NguyenHien-8/Nabertherm/README.md

# Nabertherm
- Developer: Trần Nguyên Hiền
- Instructor: Trần Hữu Danh
- Major: Electronics and Communication Engineering
- School: CAN THO UNIVERSITY
- Email: trannguyenhien29085@gmail.com
-----------------------------------------------------
<div style="display: flex; justify-content: center; gap: 10px; margin-bottom: 15px;">
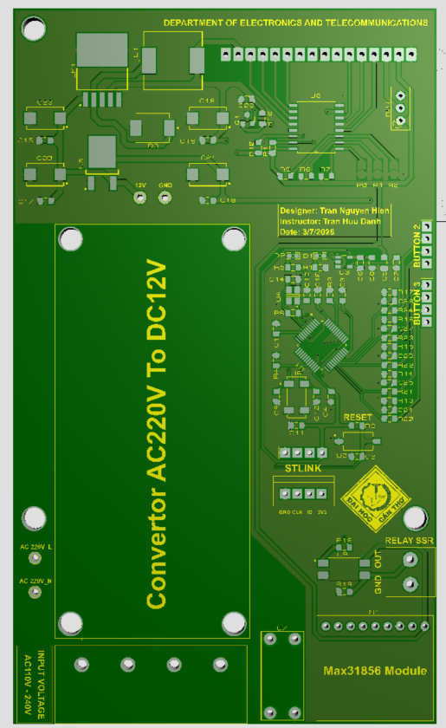
[picture p1: Document/Image/Top_3D.png]
  
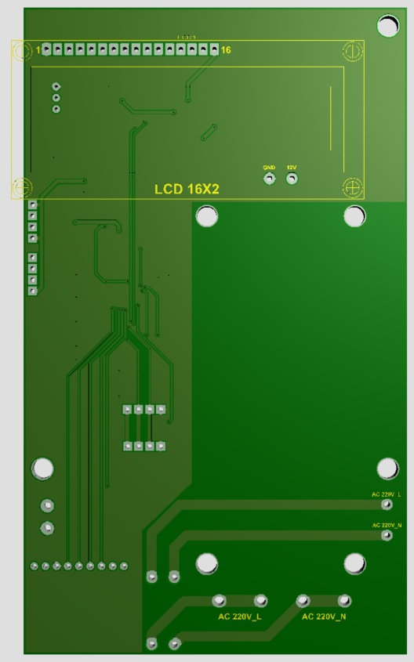
[picture p2: Document/Image/Bottom_3D.png]
  
</div>
