NguyenHien-8/Nabertherm/Document/Image/Dashboard/1786791415155_257126981631082276_1126023047263535637_b54764be3a68f17b69153251596af111.jpg

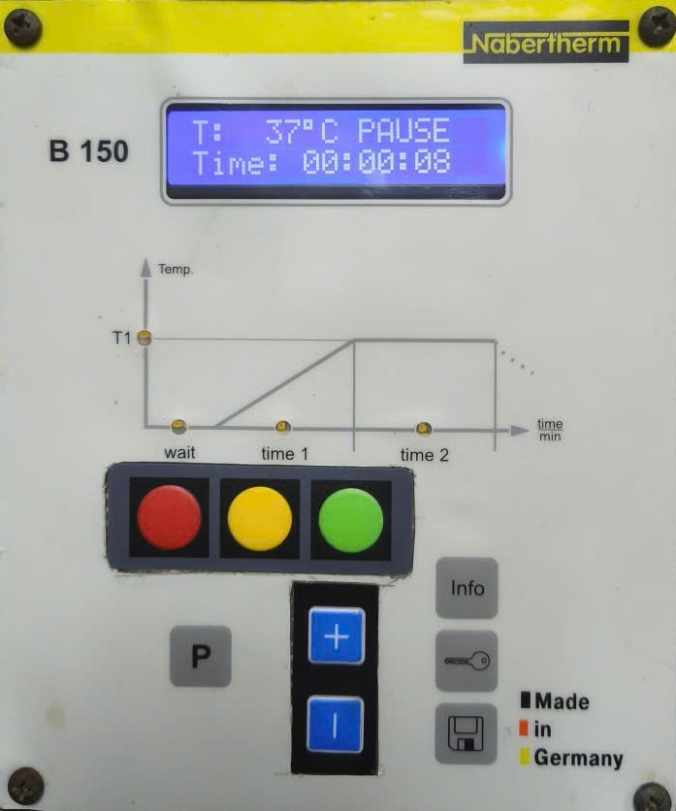
Document/Image/Dashboard/1786791415155_257126981631082276_1126023047263535637_b54764be3a68f17b69153251596af111.jpg
