NguyenHien-8/Nabertherm/Document/Image/Dashboard/1786791415245_257126981631082276_1126023047263535637_783d4723ad5a51a8d0b6619117eda769.jpg

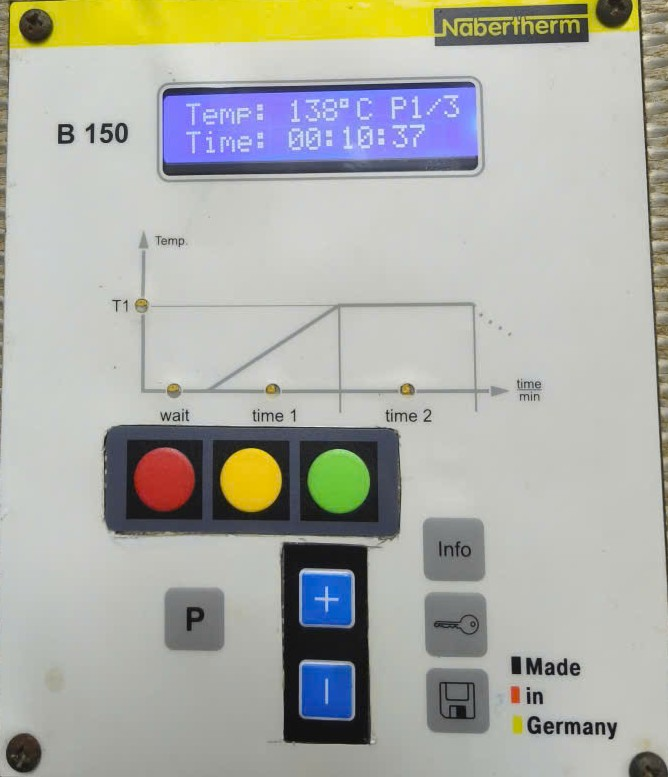
Document/Image/Dashboard/1786791415245_257126981631082276_1126023047263535637_783d4723ad5a51a8d0b6619117eda769.jpg
