NguyenHien-8/Nabertherm/Document/Image/Dashboard/1786791415838_257126981631082276_1126023047263535637_0a16da0144fe33b08d0fe1ec7425ece5.jpg

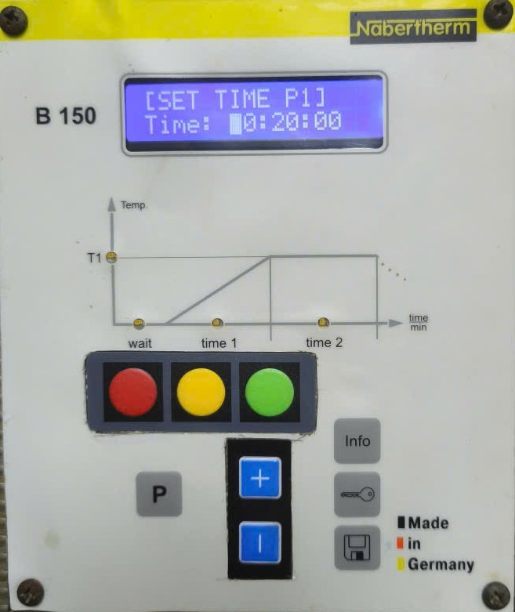
Document/Image/Dashboard/1786791415838_257126981631082276_1126023047263535637_0a16da0144fe33b08d0fe1ec7425ece5.jpg
