NguyenHien-8/Nabertherm/Document/Image/Flowchart/01_main_flow.png

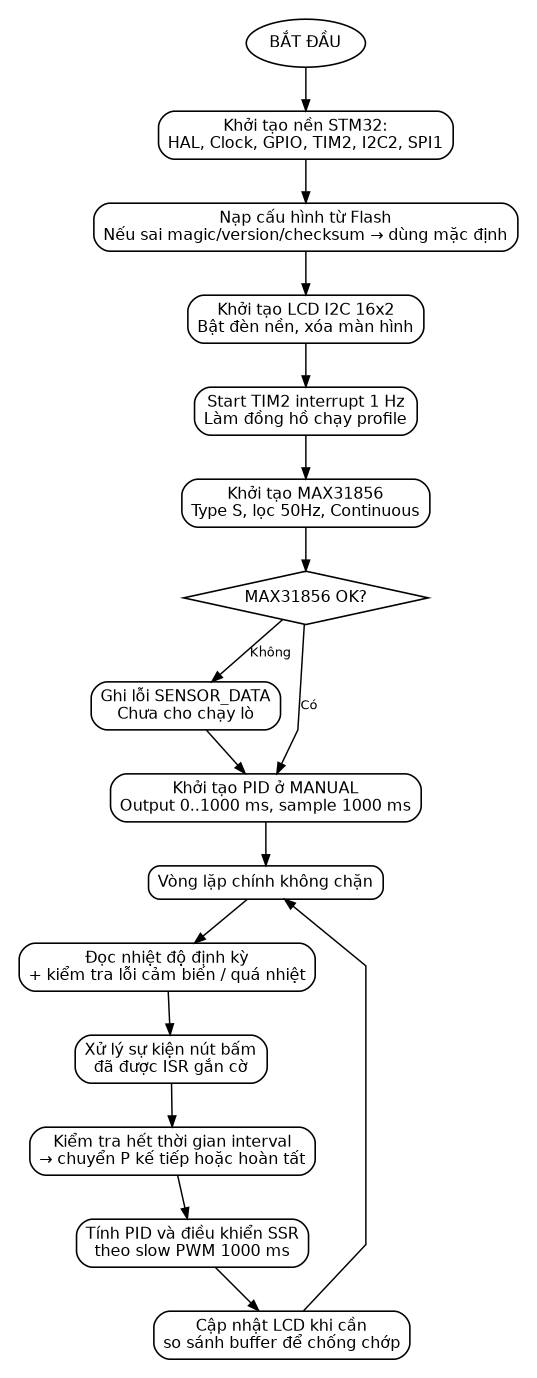
Document/Image/Flowchart/01_main_flow.png
