NguyenHien-8/Nabertherm/Document/Image/Flowchart/02_interrupt_flow.png

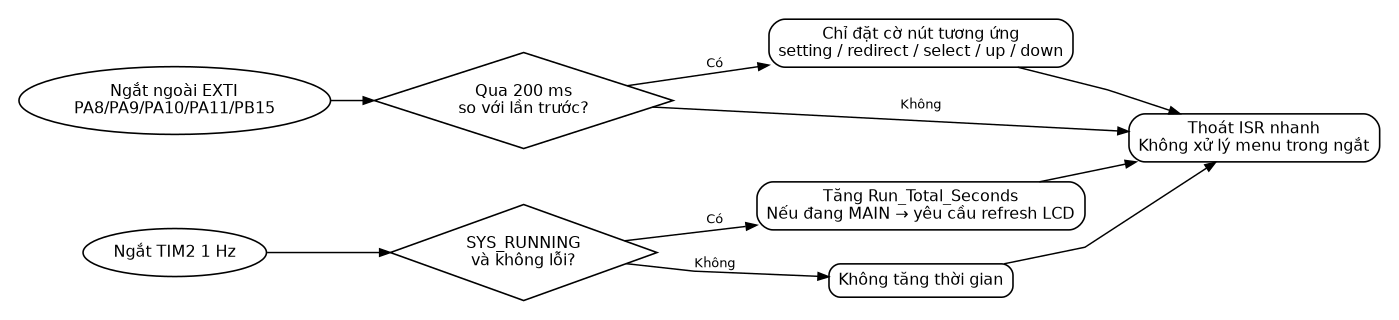
Document/Image/Flowchart/02_interrupt_flow.png
