NguyenHien-8/Nabertherm/Document/Image/Flowchart/03_read_temperature.png

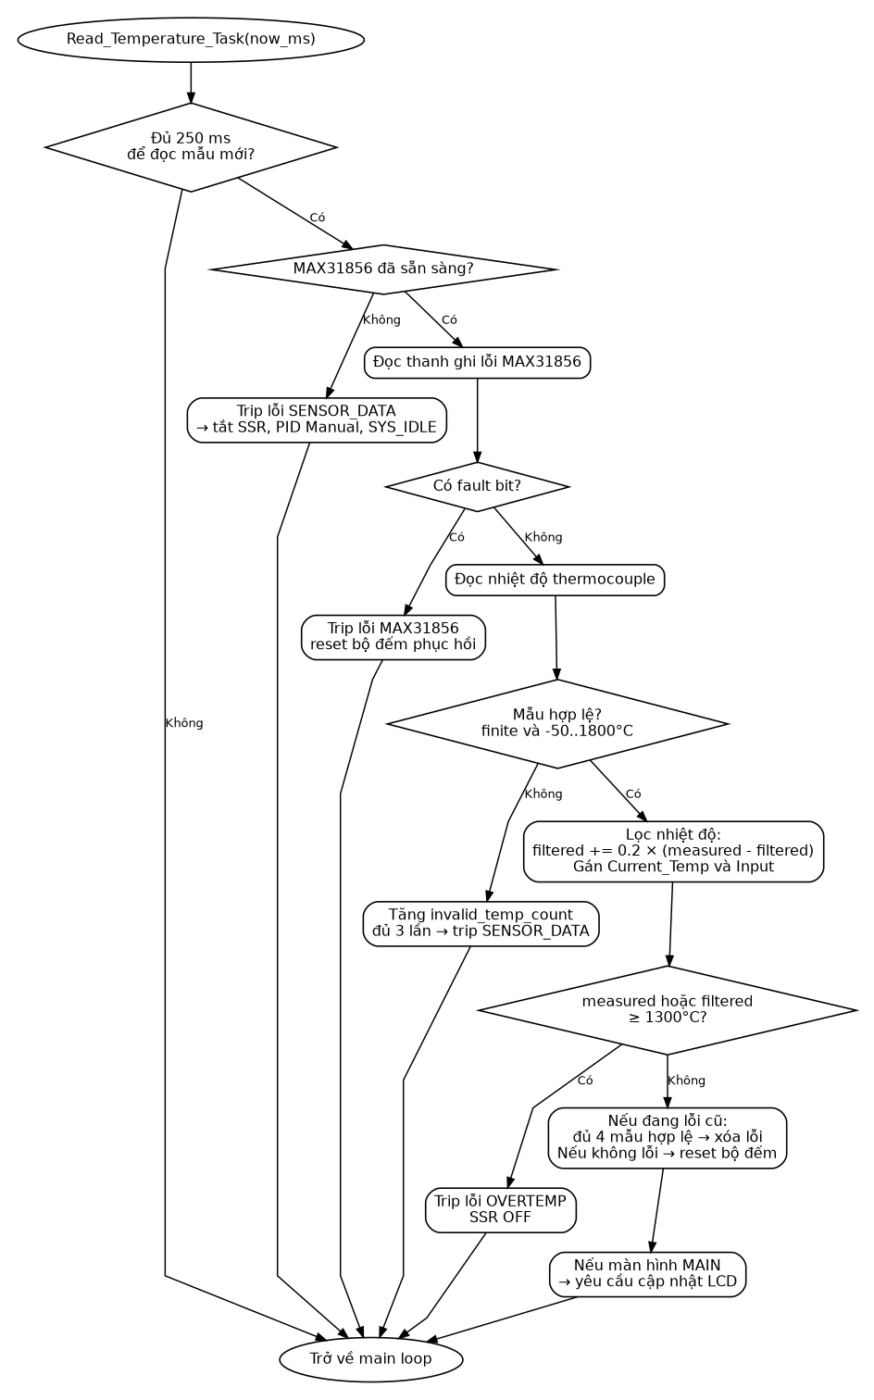
Document/Image/Flowchart/03_read_temperature.png
