NguyenHien-8/Nabertherm/Document/Image/Flowchart/04_process_buttons.png

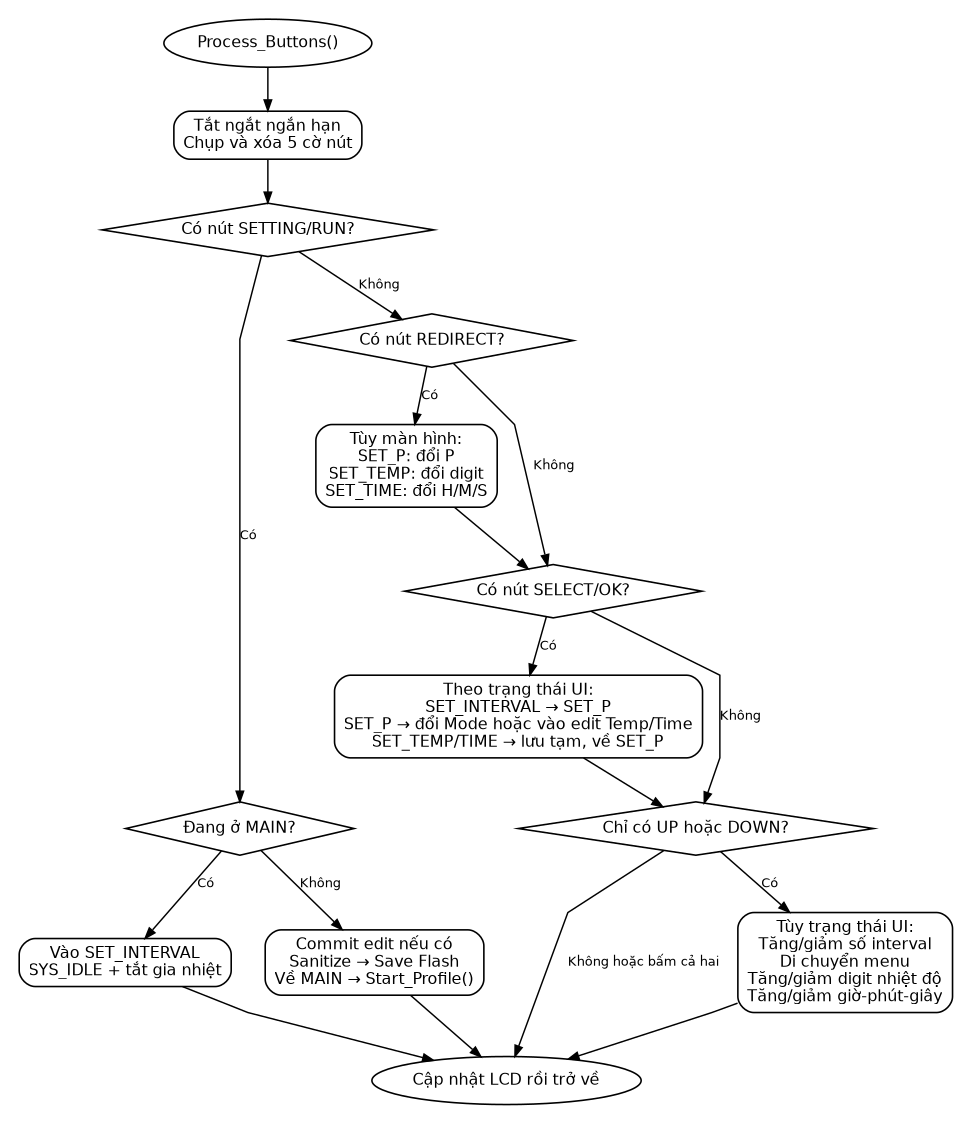
Document/Image/Flowchart/04_process_buttons.png
