NguyenHien-8/Nabertherm/Document/Image/Flowchart/05_profile_flow.png

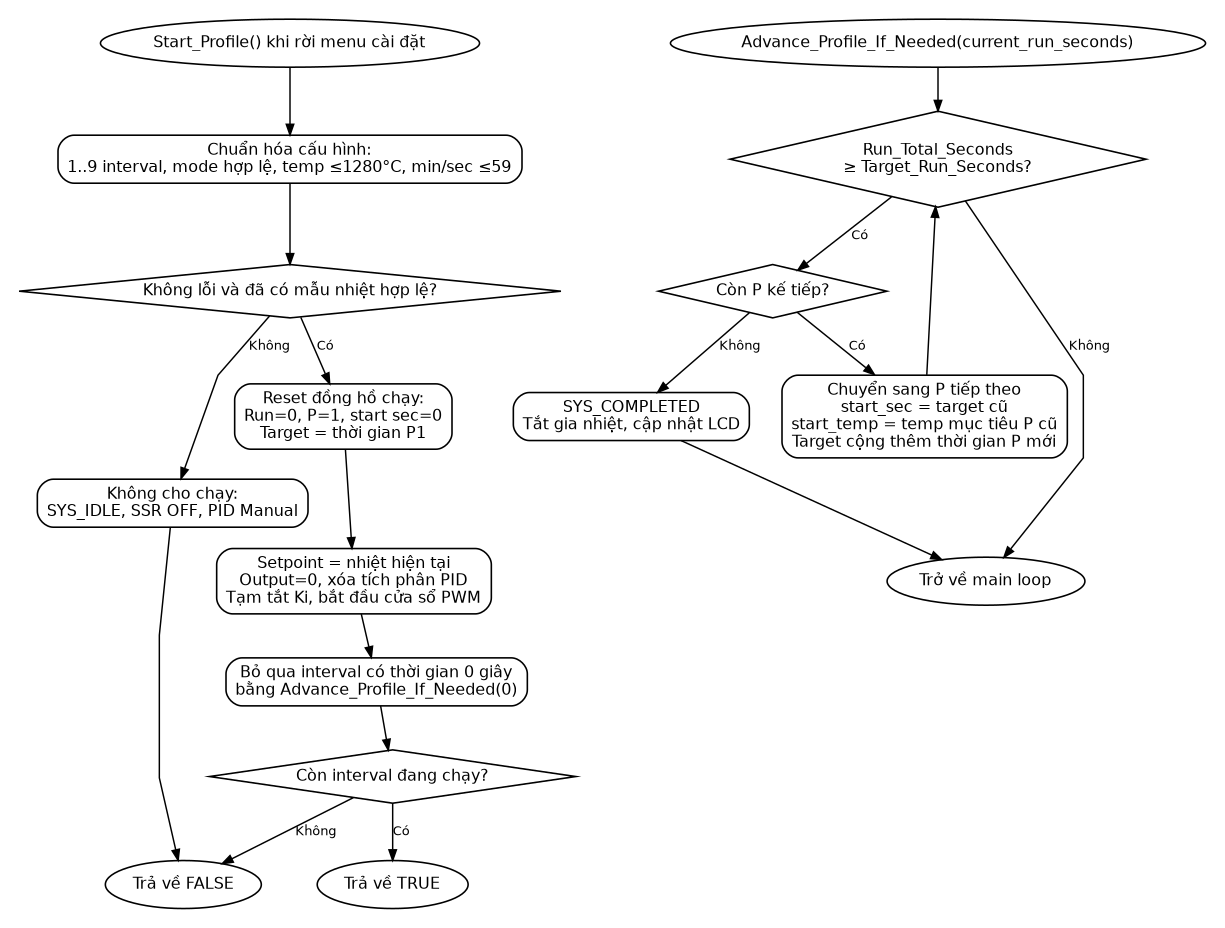
Document/Image/Flowchart/05_profile_flow.png
