NguyenHien-8/Nabertherm/Document/Image/Flowchart/06_pid_ssr.png

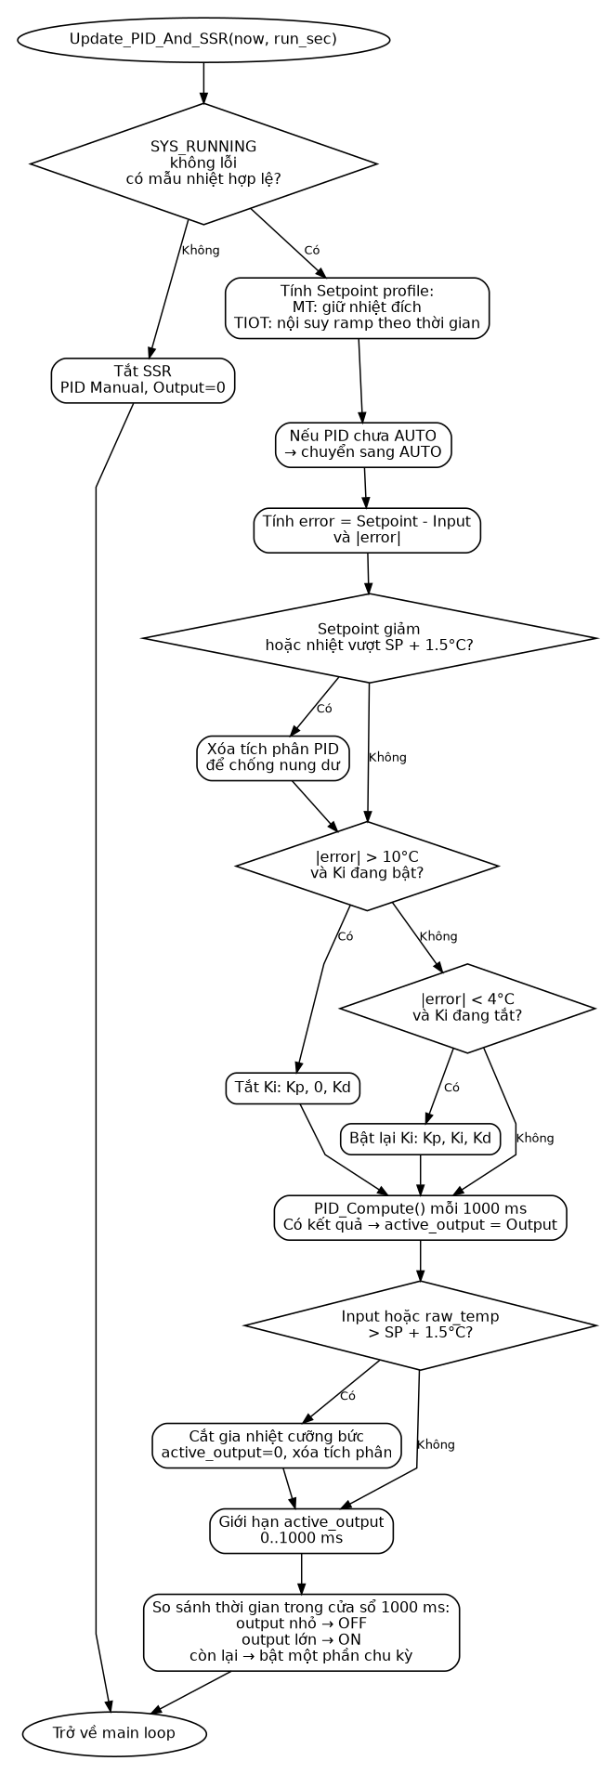
Document/Image/Flowchart/06_pid_ssr.png
