NguyenHien-8/Nabertherm/Document/Image/Flowchart/07_lcd_update.png

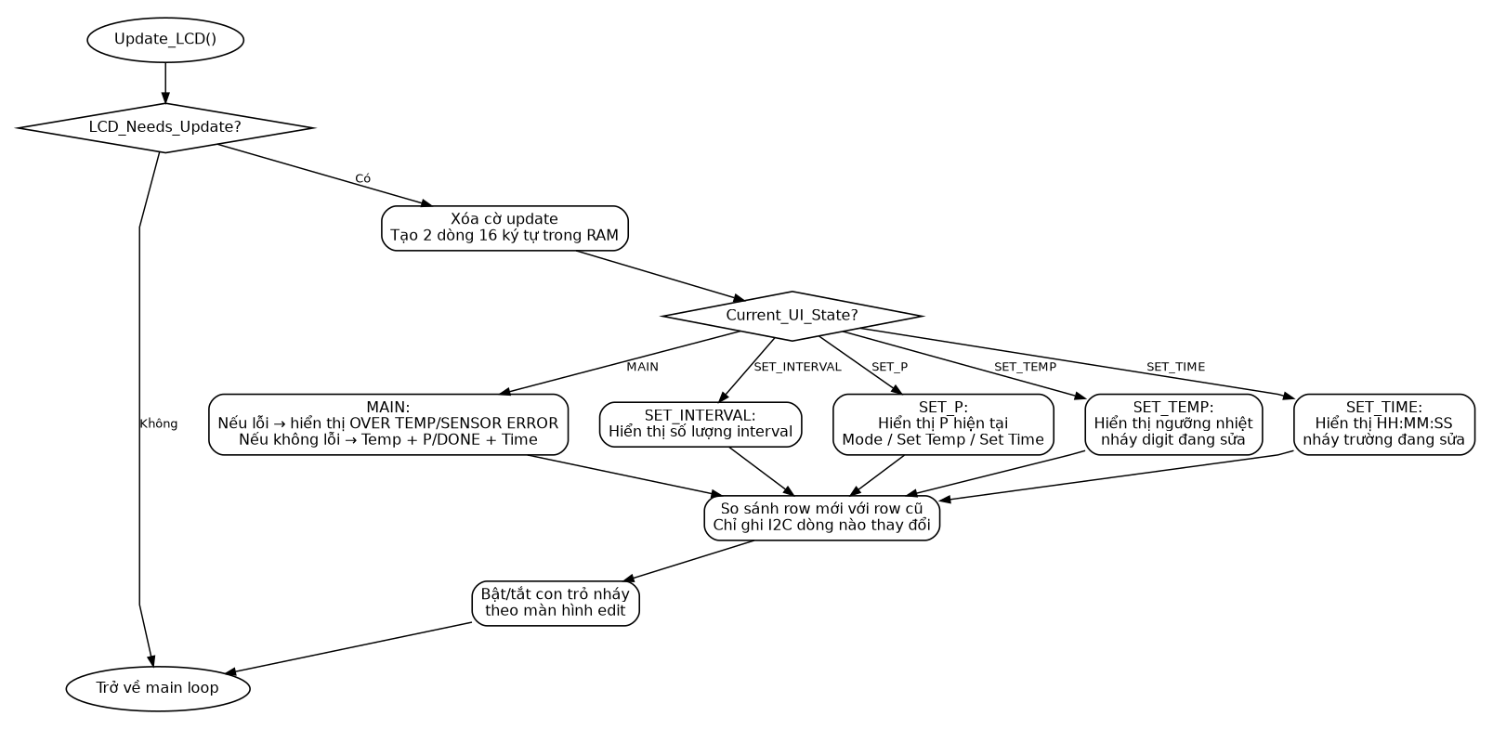
Document/Image/Flowchart/07_lcd_update.png
