NguyenHien-8/Nabertherm/Document/Image/Flowchart/08_library_roles.png

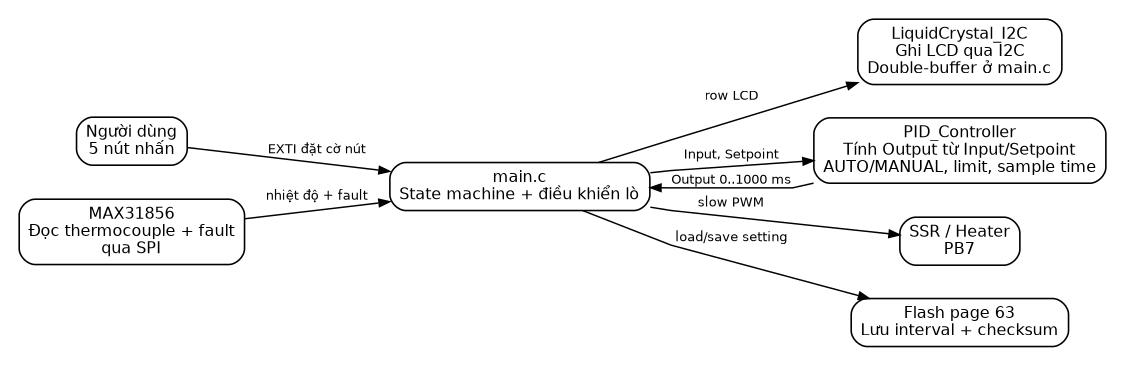
Document/Image/Flowchart/08_library_roles.png
