NguyenHien-8/Nabertherm/Document/Image/PCB_Layout.png

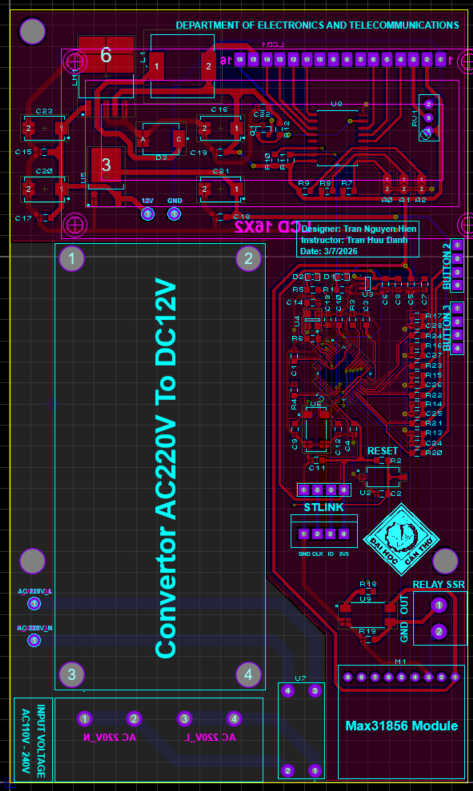
Document/Image/PCB_Layout.png
