NguyenHien-8/Nabertherm/(list of files, drawings)

Other design files:
Nabertherm_PCB/Nabertherm_PCB.pdsprj
Nabertherm_PCB/Project Backups/Nabertherm_PCB [20260711, 18-50-51].pdsprj
Nabertherm_PCB/Project Backups/Nabertherm_PCB [20260711, 18-58-28].pdsprj
Nabertherm_PCB/Project Backups/Nabertherm_PCB [20260711, 18-58-45].pdsprj
Nabertherm_PCB/Project Backups/Nabertherm_PCB [20260711, 18-58-46].pdsprj
Nabertherm_PCB/Project Backups/Nabertherm_PCB [20260711, 18-59-52].pdsprj
Nabertherm_PCB/Project Backups/Nabertherm_PCB [20260711, 19-00-42].pdsprj
Nabertherm_PCB/Project Backups/Nabertherm_PCB [20260711, 21-24-59].pdsprj
Nabertherm_PCB/Project Backups/Nabertherm_PCB [20260711, 21-25-00].pdsprj
Nabertherm_PCB/Project Backups/Nabertherm_PCB [20260711, 22-18-30].pdsprj
Nabertherm_PCB/Project Backups/Nabertherm_PCB [20260722, 23-25-37].pdsprj
