NguyenHien-8/Nabertherm/Temperature_Control_Algorithm/Core/Src/main.c

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
/* Includes ------------------------------------------------------------------*/
#include "main.h"

/* USER CODE BEGIN Includes */
#include "LiquidCrystal_I2C.h"
#include "MAX31856.h"
#include "PID_Controller.h"
#include <stdio.h>
#include <stdlib.h>
#include <math.h>
/* USER CODE END Includes */

I2C_HandleTypeDef hi2c2;

SPI_HandleTypeDef hspi1;

/* USER CODE BEGIN PV */
// Khai báo các object điều khiển
MAX31856_HandleTypeDef max31856;
PID_TypeDef pid_heater;

// Biến cho PID
float Input, Output, Setpoint;
float Kp = 20.0f, Ki = 0.02f, Kd = 300.0f;

// Biến cho Time-Proportional Control (Slow PWM)
#define WINDOW_SIZE 1000 // Chu kỳ băm xung là 1000ms (1 giây)
uint32_t windowStartTime = 0;
float active_output = 0; // Biến "chốt" (lock) Output cho 1 chu kỳ PWM

// Các biến định thời phi nghẽn
uint32_t lastSensorUpdate = 0;
uint32_t lastLcdUpdate = 0;
uint8_t sensor_fault = 0; // Biến lưu trạng thái lỗi cảm biến
/* USER CODE END PV */

void SystemClock_Config(void);
static void MX_GPIO_Init(void);
static void MX_I2C2_Init(void);
static void MX_SPI1_Init(void);
/**
  * @brief  The application entry point.
  * @retval int
  */
int main(void)
{

  /* MCU Configuration--------------------------------------------------------*/

  /* Reset of all peripherals, Initializes the Flash interface and the Systick. */
  HAL_Init();

  /* Configure the system clock */
  SystemClock_Config();

  /* Initialize all configured peripherals */
  MX_GPIO_Init();
  MX_I2C2_Init();
  MX_SPI1_Init();
  /* USER CODE BEGIN 2 */
  // 1. Init LCD 16x2
    LCDI2C_init(&hi2c2, 0x27, 16, 2);
    LCDI2C_backlight();
    LCDI2C_clear();

  // 2. Khởi tạo cảm biến MAX31856
    MAX31856_Init(&max31856, &hspi1, GPIOA, GPIO_PIN_15);
    MAX31856_SetThermocoupleType(&max31856, MAX31856_TCTYPE_S);
    MAX31856_SetNoiseFilter(&max31856, MAX31856_NOISE_FILTER_50HZ);
    MAX31856_SetConversionMode(&max31856, MAX31856_CONTINUOUS);

  // 3. Khởi tạo bộ PID
    Setpoint = 150.0f;
    PID_Init(&pid_heater, &Input, &Output, &Setpoint, Kp, Ki, Kd, PID_P_ON_E, PID_DIRECT);
    PID_SetMode(&pid_heater, PID_AUTOMATIC);
    PID_SetOutputLimits(&pid_heater, 0, WINDOW_SIZE);

    // Đồng bộ Chu kỳ tính toán PID đúng bằng chu kỳ băm xung SSR
    PID_SetSampleTime(&pid_heater, WINDOW_SIZE);
    windowStartTime = HAL_GetTick();

    // Biến dùng cho bộ lọc EMA (Exponential Moving Average)
     static float filtered_temp = -1.0f;
    // Trạng thái Anti-Windup để tránh gọi hàm SetTunings liên tục
     static bool ki_is_active = true;
  /* USER CODE END 2 */

  /* Infinite loop */
  /* USER CODE BEGIN WHILE */
  while (1)
  {
	  uint32_t currentTick = HAL_GetTick();
      /* ==================================================================== */
      /* CHU KỲ 1: ĐỌC VÀ LỌC NHIỄU CẢM BIẾN (Chạy định kỳ 250ms)             */
      /* ==================================================================== */
      if (currentTick - lastSensorUpdate >= 250)
      {
          lastSensorUpdate = currentTick;

          // Kiểm tra lỗi cảm biến
          sensor_fault = MAX31856_ReadFault(&max31856);

          if (sensor_fault == 0)
          {
              float temp_read = MAX31856_ReadThermocoupleTemperature(&max31856);
              if (temp_read > -0.1f && temp_read < 500.0f) { // Lọc giá trị rác cực đoan
                  if (filtered_temp < 0.0f) filtered_temp = temp_read;
                  else filtered_temp = 0.8f * filtered_temp + 0.2f * temp_read; // Bộ lọc EMA
                  Input = filtered_temp;
              }
          } else {
              // Bảo vệ phần cứng: Tắt gia nhiệt ngay lập tức nếu cảm biến lỗi
              PID_SetMode(&pid_heater, PID_MANUAL);
              active_output = 0;
              Output = 0;
          }
      }

      /* ==================================================================== */
      /* CHU KỲ 2: TÍNH TOÁN PID VÀ CẬP NHẬT CHU KỲ PWM                       */
      /* ==================================================================== */
      if (sensor_fault == 0) {
          if (PID_GetMode(&pid_heater) != PID_AUTOMATIC) {
              PID_SetMode(&pid_heater, PID_AUTOMATIC);
          }

          // Anti-Windup: Chỉ bật khâu I (Tích phân) khi cách đích <= 5 độ C
          float error = Setpoint - Input;
          if (fabs(error) > 5.0f && ki_is_active) {
              PID_SetTunings(&pid_heater, Kp, 0.0f, Kd, PID_P_ON_E);
              ki_is_active = false;
          } else if (fabs(error) <= 5.0f && !ki_is_active) {
              PID_SetTunings(&pid_heater, Kp, Ki, Kd, PID_P_ON_E);
              ki_is_active = true;
          }

          // Cho phép thư viện PID tự quyết định thời điểm cập nhật dựa trên SampleTime (1000ms)
          if (PID_Compute(&pid_heater)) {
              // Hàm PID_Compute trả về true -> Có giá trị Output mới
              // ĐỒNG BỘ HOÁ: Reset lại bộ đếm PWM window ngay lúc này
              windowStartTime = currentTick;
              active_output = Output;
          }
      }

      /* ==================================================================== */
      /* CHU KỲ 3: ĐIỀU KHIỂN SSR PWM (Chạy liên tục không block)             */
      /* ==================================================================== */
      if (sensor_fault != 0) {
          HAL_GPIO_WritePin(GPIOB, GPIO_PIN_7, GPIO_PIN_RESET);
      } else {
          uint32_t ms_in_window = currentTick - windowStartTime;

          // Xử lý Deadband an toàn cho SSR (Cắt bỏ dải < 20ms và giữ ON toàn thời gian nếu > 980ms)
          if (active_output <= 20) {
              HAL_GPIO_WritePin(GPIOB, GPIO_PIN_7, GPIO_PIN_RESET);
          } else if (active_output >= (WINDOW_SIZE - 20)) {
              HAL_GPIO_WritePin(GPIOB, GPIO_PIN_7, GPIO_PIN_SET);
          } else {
              // Băm xung bình thường
              if (ms_in_window < active_output) {
                  HAL_GPIO_WritePin(GPIOB, GPIO_PIN_7, GPIO_PIN_SET);
              } else {
                  HAL_GPIO_WritePin(GPIOB, GPIO_PIN_7, GPIO_PIN_RESET);
              }
          }
      }

      /* ==================================================================== */
      /* CHU KỲ 4: CẬP NHẬT LCD (Chạy định kỳ mỗi 500ms)                      */
      /* ==================================================================== */
      if (currentTick - lastLcdUpdate >= 500)
      {
          lastLcdUpdate = currentTick;
          char lcd_buf[18];

          if (sensor_fault != 0) {
              LCDI2C_setCursor(0, 0);
              LCDI2C_write_String("SENSOR ERROR!   ");
              LCDI2C_setCursor(0, 1);
              LCDI2C_write_String("SSR: OFF        ");
          } else {
              LCDI2C_setCursor(0, 0);
              snprintf(lcd_buf, sizeof(lcd_buf), "SP:%3.0f PV:%3.2f", Setpoint, Input);
              LCDI2C_write_String(lcd_buf);

              LCDI2C_setCursor(0, 1);
              // Ký hiệu [I] hiển thị để theo dõi xem bộ Anti-Windup đang bật hay tắt Tích phân
              snprintf(lcd_buf, sizeof(lcd_buf), "SSR: %4dms %c   ", (int)active_output, ki_is_active ? 'I' : ' ');
              LCDI2C_write_String(lcd_buf);
          }
      }
    /* USER CODE END WHILE */

    /* USER CODE BEGIN 3 */
  }
  /* USER CODE END 3 */
}

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
