NguyenHien-8/Nabertherm/Nabertherm_Code/Nabertherm_Code.ioc

Mcu.UserName=STM32F103C8Tx
PA10.Signal=GPXTI10
PA11.Signal=GPXTI11
PA13.Signal=SYS_JTMS-SWDIO
PA14.Signal=SYS_JTCK-SWCLK
PA8.Signal=GPXTI8
PA9.Signal=GPXTI9
PB10.Signal=I2C2_SCL
PB11.Signal=I2C2_SDA
PB15.Signal=GPXTI15
PB3.Signal=SPI1_SCK
PB4.Signal=SPI1_MISO
PB5.Signal=SPI1_MOSI
PB6.Signal=GPIO_Output
PB7.Signal=GPIO_Output
PD0-OSC_IN.Signal=RCC_OSC_IN
PD1-OSC_OUT.Signal=RCC_OSC_OUT
