NguyenHien-8/Nabertherm/Nabertherm_Code/Core/Src/main.c

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
/* Includes ------------------------------------------------------------------*/
#include "main.h"

/* USER CODE BEGIN Includes */
#include "LiquidCrystal_I2C.h"
#include "MAX31856.h"
#include "PID_Controller.h"
#include <stdio.h>
#include <string.h>
#include <stdlib.h>
#include <stdbool.h>
#include <math.h>
#include <stddef.h>
/* USER CODE END Includes */

/* USER CODE BEGIN PTD */
/* * System Operation States
 * Separated from UI states so the furnace can run in the background
 * even if the user navigates away from the main screen (future-proofing).
 */
typedef enum {
    SYS_IDLE,       // Power on or manually stopped. Timer does not increment.
    SYS_RUNNING,    // Active heating phase. Timer increments 1Hz.
    SYS_PAUSED,     // Process timeline frozen; SSR is forced OFF until resumed.
    SYS_COMPLETED   // All intervals finished. Timer stops, retains last time.
} SystemState_t;

/* * User Interface (Menu) States
 * Defines exactly which screen the user is currently viewing.
 */
typedef enum {
    UI_STATE_MAIN,
    UI_STATE_SET_INTERVAL,
    UI_STATE_SET_P,
    UI_STATE_SET_TEMP,
    UI_STATE_SET_TIME,
    UI_STATE_PROGRAM_MANAGER,
    UI_STATE_OPERATION_CONFIRM
} UIState_t;

typedef enum {
    CONFIRM_ACTION_SAVE,
    CONFIRM_ACTION_DELETE
} ConfirmAction_t;

/* Heating Modes */
typedef enum {
    MODE_MT,    // Maintain Temp: PID holds setpoint constantly.
    MODE_TIOT   // Temp Increases Over Time: Ramp rate applied to PID setpoint.
} IntervalMode_t;

/* Latched control faults. Any active fault forces the SSR OFF. */
typedef enum {
    CONTROL_FAULT_NONE = 0,
    CONTROL_FAULT_MAX31856,
    CONTROL_FAULT_SENSOR_DATA,
    CONTROL_FAULT_OVERTEMP
} ControlFault_t;

/* MODE_MT supervisory phases for a high-inertia furnace. */
typedef enum {
    MT_PHASE_APPROACH = 0, /* Heat toward the target with power tapering. */
    MT_PHASE_COAST,        /* SSR OFF while stored heat continues to raise temperature. */
    MT_PHASE_HOLD          /* Tight PID regulation around the requested Setpoint. */
} MTControlPhase_t;

/* * Data structure for a single heating interval (Segment).
 * Grouped into a struct for memory contiguity and easy array management.
 */
typedef struct {
    uint8_t Mode;                 // Stored as a fixed-width value for stable Flash layout.
    uint16_t Temp;
    uint8_t Time_Hour;
    uint8_t Time_Min;
    uint8_t Time_Sec;
} Interval_TypeDef;

/* USER CODE END PTD */

/* USER CODE BEGIN PD */
// 200ms software debounce prevents mechanical button switch bouncing
// from triggering multiple interrupts.
#define DEBOUNCE_DELAY 200
#define BUTTON_LONG_PRESS_MS             1200U
#define OPERATION_CONFIRM_DISPLAY_MS     1200U

// Max segments allowed by the system memory/requirements.
#define MAX_INTERVALS 9
#define MAX_PROGRAMS  9
#define NO_PROGRAM_SLOT                  0xFFU
#define PROGRAM_VALID_MARKER             0x43505247UL /* "CPRG" */

// Variable for Time-Proportional Control (Slow PWM)
#define WINDOW_SIZE 1000

/* Scheduling, sensor validation and safety limits. */
#define SENSOR_SAMPLE_MS                  250U
#define SENSOR_INVALID_LIMIT              3U
#define SENSOR_RECOVERY_VALID_SAMPLES     4U
#define SENSOR_MIN_VALID_C               (-50.0f)
#define SENSOR_MAX_VALID_C               (1800.0f)
#define PROCESS_MAX_TEMP_C                1280U
#define OVERTEMP_TRIP_C                  (1300.0f)
#define OVERTEMP_RESET_C                 (1250.0f)
#define TEMP_FILTER_ALPHA                (0.20f)

/* TIOT keeps the original PID zoning. MODE_MT uses its own tighter controller. */
#define INTEGRAL_ENABLE_BAND_C             4.0f
#define INTEGRAL_DISABLE_BAND_C           10.0f
#define HEATER_CUTOFF_ABOVE_SP_C           1.5f
#define OUTPUT_DEADBAND_MS                20.0f

/* MODE_MT predictive anti-overshoot and hold-control parameters.
 * These are conservative starting values for the 3 kW Nabertherm furnace.
 * Final +/-1 degC performance must be verified and tuned on the real furnace/load.
 */
#define TEMP_RATE_UPDATE_MS             5000U
#define TEMP_RATE_FILTER_ALPHA             0.25f
#define TEMP_RATE_MAX_ABS_C_PER_MIN       80.0f

#define MT_TARGET_TOLERANCE_C              1.0f
#define MT_HARD_CUTOFF_C                   0.30f

/* MT soft-landing:
 * The previous 4-minute look-ahead could switch the SSR OFF about 10...12 degC
 * before Setpoint on this furnace. Use the already-observed furnace coast scale
 * (~0.42 min) and only predictively coast very near the target.
 */
#define MT_PREDICT_MARGIN_C                0.20f
#define MT_THERMAL_LOOKAHEAD_MIN           0.42f
#define MT_PREDICT_ACTIVE_BAND_C           2.50f
#define MT_MIN_RISING_RATE_C_PER_MIN       0.15f

/* Enter/leave HOLD around the requested tolerance band.
 * Small deviations stay in HOLD so the integral is not repeatedly erased.
 */
#define MT_HOLD_ENTRY_ERROR_C              1.00f
#define MT_HOLD_ENTRY_RATE_C_PER_MIN       0.80f
#define MT_REHEAT_ERROR_C                  3.00f
#define MT_COAST_RELEASE_ERROR_C           0.60f
#define MT_COAST_RELEASE_RATE_C_PER_MIN    0.30f
#define MT_HOLD_MIN_PULSE_MS              40.0f
#define MT_HOLD_BIAS_FRACTION              0.75f
#define MT_HOLD_BIAS_CAP_FRACTION          0.35f
#define MT_HOLD_FLOOR_START_ERROR_C        0.60f
#define MT_HOLD_RECOVERY_ERROR_C           0.90f
#define MT_HOLD_FLOOR_FRACTION             0.35f
#define MT_HOLD_RECOVERY_FRACTION          0.55f

/* Gain scheduling: no integral during approach/coast; stronger PI action in hold. */
#define MT_APPROACH_KP                    25.0f
#define MT_APPROACH_KD                   180.0f
#define MT_HOLD_KP                       120.0f
#define MT_HOLD_KI                         2.00f
#define MT_HOLD_KD                       180.0f

/* Maximum SSR ON time in each 1000 ms window while approaching Setpoint.
 * Keep enough authority near target to overcome furnace heat loss; predictive
 * coast now handles overshoot instead of starving the heater 10 degC early.
 */
#define MT_MAX_OUTPUT_FAR_MS            1000.0f
#define MT_MAX_OUTPUT_40_20_MS           900.0f
#define MT_MAX_OUTPUT_20_10_MS           750.0f
#define MT_MAX_OUTPUT_10_5_MS            550.0f
#define MT_MAX_OUTPUT_5_3_MS             450.0f
#define MT_MAX_OUTPUT_3_2_MS             350.0f
#define MT_MAX_OUTPUT_2_1_MS             280.0f
#define MT_MAX_OUTPUT_NEAR_MS            220.0f

/* MODE_TIOT linear trajectory tracking.
 *
 * The commanded Setpoint is the exact time interpolation from start to target;
 * it is never advanced above that line. Heater demand combines:
 *   1. feed-forward for the programmed ramp rate,
 *   2. signed pace correction (behind/ahead of the line), and
 *   3. signed temperature-rate feedback.
 *
 * Example: 40 -> 140 degC in 20 min gives exactly 5 degC/min and a 90 degC
 * reference at minute 10. The initial full-power estimate of 7 degC/min comes
 * from the reported 40 -> 110 degC / 10 min observation and is learned online.
 */
#define TIOT_TARGET_TOLERANCE_C             0.25f
#define TIOT_HARD_CUTOFF_C                  0.10f
#define TIOT_KP                            35.0f
#define TIOT_KI                             0.10f
#define TIOT_KD                           250.0f
#define TIOT_INTEGRAL_ENABLE_BAND_C        30.0f

#define TIOT_TRACK_CORRECTION_MAX_MIN        2.00f
#define TIOT_TRACK_CORRECTION_MIN_MIN        0.25f
#define TIOT_RATE_FEEDBACK_MS_PER_C_MIN      45.0f
#define TIOT_TRAJECTORY_LOOKAHEAD_MIN         0.20f
#define TIOT_TRAJECTORY_BRAKE_BAND_C          0.75f

#define TIOT_INITIAL_FULL_POWER_RATE_C_MIN   7.0f
#define TIOT_RATE_EST_ALPHA                 0.10f
#define TIOT_RATE_EST_WARMUP_SEC           45U
#define TIOT_RATE_EST_MIN_OUTPUT_MS       650.0f
#define TIOT_RATE_EST_MIN_C_MIN             0.10f
#define TIOT_RATE_EST_MIN_FULL_C_MIN        0.50f
#define TIOT_RATE_EST_MAX_FULL_C_MIN       40.0f
#define TIOT_RATE_EST_FREEZE_BAND_C         3.0f
#define TIOT_MIN_USEFUL_PULSE_MS            40.0f

#define TIOT_FAST_RATE_UPDATE_MS          1500U
#define TIOT_FAST_RATE_ALPHA                0.60f
#define TIOT_FAST_RATE_MAX_ABS_C_MIN       80.0f

/* Independent Watchdog (IWDG) runtime safety.
 * Direct register programming is used so this source remains drop-in compatible
 * even if HAL_IWDG_MODULE_ENABLED was not previously enabled in stm32f1xx_hal_conf.h.
 * With nominal 40 kHz LSI, /64 and reload 2499 give about 4 s.
 */
#define IWDG_KR_START_KEY                  0xCCCCU
#define IWDG_KR_WRITE_ACCESS_KEY           0x5555U
#define IWDG_KR_REFRESH_KEY                0xAAAAU
#define IWDG_PR_DIV64_VALUE                0x04U
#define IWDG_RELOAD_VALUE                  2499U
#define IWDG_CONFIG_TIMEOUT_MS              100U

// Flash Storage Architecture
// STM32F103C8T6 has 64KB Flash. Page 63 is the very last page (1KB size).
// Using the last page ensures we do not accidentally overwrite application code.
#define FLASH_STORAGE_ADDR 0x0800FC00
#define FLASH_MAGIC_WORD   0xAABBCCDE
#define FLASH_DATA_VERSION 3U
#define FLASH_LEGACY_VERSION 2U
/* USER CODE END PD */

I2C_HandleTypeDef hi2c2;

SPI_HandleTypeDef hspi1;

TIM_HandleTypeDef htim2;


/* USER CODE BEGIN PV */
MAX31856_HandleTypeDef max31856;
PID_TypeDef pid_heater;

/* Version-2 record retained only for one-time migration. */
typedef struct {
    uint32_t MagicWord;
    uint32_t Version;
    uint32_t TotalIntervals;
    Interval_TypeDef Intervals[MAX_INTERVALS];
    uint32_t Checksum;
} Legacy_Flash_Data_t;

typedef struct {
    uint32_t ValidMarker;
    uint32_t TotalIntervals;
    Interval_TypeDef Intervals[MAX_INTERVALS];
} Stored_Program_t;

/* Version-3 record: one working profile plus nine named program slots C1...C9.
 * A global checksum covers the complete database. The staging object is global
 * instead of stack-local because the STM32F103 project reserves only 1 KiB stack.
 */
typedef struct {
    uint32_t MagicWord;
    uint32_t Version;
    uint32_t ActiveProgramSlot;
    uint32_t WorkingTotalIntervals;
    Interval_TypeDef WorkingIntervals[MAX_INTERVALS];
    Stored_Program_t Programs[MAX_PROGRAMS];
    uint32_t Checksum;
} Flash_Data_t;

_Static_assert(sizeof(Flash_Data_t) <= 1024U,
               "Program database exceeds STM32F103 1 KiB Flash page");
_Static_assert((sizeof(Flash_Data_t) % 4U) == 0U,
               "Program database must be word aligned for Flash programming");

Flash_Data_t flash_staging_data;
Stored_Program_t Stored_Programs[MAX_PROGRAMS];
/* Main-loop-only rollback buffer avoids placing an 80-byte program record on
 * the STM32F103's small call stack while Flash HAL routines are nested. */
Stored_Program_t program_rollback_data;

// ================= PID PARAMETTERS & NOISE FILTER =================
float Input, Output, Setpoint;
float Kp = 20.0f, Ki = 0.02f, Kd = 250.0f;
uint32_t windowStartTime = 0;
float active_output = 0;
float filtered_temp = -1.0f;
float raw_temp = 0.0f;
bool ki_is_active = true;
float last_setpoint = 0.0f;
uint8_t max31856_fault_bits = 0;
uint8_t invalid_temp_count = 0;
uint8_t valid_recovery_count = 0;
bool sensor_has_valid_sample = false;
bool max31856_ready = false;
volatile ControlFault_t Control_Fault = CONTROL_FAULT_NONE;

//========== Multi-Pin Independent Debounce Variables ==========//
/*
 * Button Event Flags
 * WHY: The EXTI ISR should be as short as possible. We only set flags here.
 * The heavy logic (state changing, flash writing) is deferred to Process_Buttons()
 * in the main loop.
 */
volatile uint32_t last_time_PA8 = 0;
volatile uint32_t last_time_PA9 = 0;
volatile uint32_t last_time_PA10 = 0;
volatile uint32_t last_time_PA11 = 0;
volatile uint32_t last_time_PB15 = 0;

volatile uint8_t button_setting = 0;    // PA8 short -> Setting/Run
volatile uint8_t button_setting_long = 0;
volatile uint8_t button_setting_press = 0;
volatile uint8_t button_redirect = 0;   // PA9 short -> Redirect
volatile uint8_t button_redirect_long = 0;
volatile uint8_t button_redirect_press = 0;
volatile uint8_t button_select = 0;     // PB15 short -> OK/Select
volatile uint8_t button_select_long = 0;
volatile uint8_t button_select_press = 0;
volatile uint8_t button_tang = 0;       // PA11 -> UP
volatile uint8_t button_giam = 0;       // PA10 -> DOWN

bool setting_press_tracking = false;
bool setting_long_emitted = false;
uint32_t setting_press_start_ms = 0U;
bool redirect_press_tracking = false;
bool redirect_long_emitted = false;
uint32_t redirect_press_start_ms = 0U;
bool select_press_tracking = false;
bool select_long_emitted = false;
uint32_t select_press_start_ms = 0U;

// ================= SYSTEM LOGIC & UI =================
/* System Logic & Payload Variables */
Interval_TypeDef Intervals[MAX_INTERVALS];
uint8_t Total_Intervals = 1;

volatile SystemState_t System_Run_State = SYS_IDLE;
volatile UIState_t Current_UI_State = UI_STATE_MAIN;
uint8_t Current_Interval = 1;

// Single atomic source of truth for the global run clock.
volatile uint32_t Run_Total_Seconds = 0;

/*
 * Target_Run_Seconds is the absolute cumulative target time.
 * WHY: Instead of resetting the clock to 0 at the start of a new interval
 * (which looks bad on the UI), we calculate the absolute total seconds needed
 * to finish the current interval and compare it against the running clock.
 */
uint32_t Target_Run_Seconds = 0;
float Current_Temp = 0.0f;

// Linear interpolation TIOT variables
uint32_t Current_Interval_Start_Sec = 0;
float Current_Interval_Start_Temp = 0.0f;

/* Menu Navigation Variables */
uint8_t Setting_P_Index = 1;        // Tracks which interval (P1...Pn) is being edited.
uint8_t Menu_Cursor = 0;            // 0: Mode, 1: Set Temp, 2: Set Time.
uint8_t Temp_Digit_Index = 0;       // For individual digit blinking (Thousands, Hundreds, etc.).
uint8_t Time_Field_Index = 0;       // 0: Hour, 1: Min, 2: Sec.

/* Saved-program manager and transient operation-confirmation UI. */
uint8_t Active_Program_Slot = NO_PROGRAM_SLOT;
uint8_t Working_Program_Slot = NO_PROGRAM_SLOT;
uint8_t Program_Manager_Selection = 0U;
uint8_t Program_Manager_Top = 0U;
bool Editing_From_Program_Manager = false;
UIState_t Confirmation_Return_State = UI_STATE_MAIN;
uint32_t Confirmation_Until_Ms = 0U;
bool Confirmation_Success = false;
ConfirmAction_t Confirmation_Action = CONFIRM_ACTION_SAVE;
uint8_t Confirmation_Program_Slot = NO_PROGRAM_SLOT;

/* Temporary Editing Buffers */
// Edits are stored here first, and only pushed to the actual Interval struct upon pressing 'Select'.
uint16_t Temp_Edit_Val = 0;
uint8_t Time_Edit_H = 0, Time_Edit_M = 0, Time_Edit_S = 0;

/* Display Optimization Variables */
volatile bool LCD_Needs_Update = true;
char prev_lcd_row1[17] = {0}; // Cache for Row 1
char prev_lcd_row2[17] = {0}; // Cache for Row 2
uint32_t last_temp_read_time = 0;
bool flash_write_ok = true;

/* MODE_MT state, temperature-rate estimator and transition memory. */
float temp_rate_c_per_min = 0.0f;
float temp_rate_last_temp = 0.0f;
uint32_t temp_rate_last_time_ms = 0U;
bool temp_rate_initialized = false;
MTControlPhase_t mt_control_phase = MT_PHASE_APPROACH;
float mt_predicted_temp_c = 0.0f;
float mt_output_limit_ms = 0.0f;
float mt_precoast_output_ms = 0.0f;
uint8_t last_control_interval = 0U;
uint8_t last_control_mode = 0xFFU;

/* Pause/resume snapshots. The PID integral and last real actuator demand are
 * retained so continuing the process does not behave like a new profile.
 */
float paused_pid_output_sum = 0.0f;
float paused_active_output_ms = 0.0f;

/* MODE_TIOT linear-ramp diagnostics and adaptive furnace-rate estimate. */
float tiot_ideal_temp_c = 0.0f;
float tiot_command_setpoint_c = 0.0f;
float tiot_planned_rate_c_per_min = 0.0f;
float tiot_required_rate_c_per_min = 0.0f;
float tiot_full_power_rate_est_c_per_min = TIOT_INITIAL_FULL_POWER_RATE_C_MIN;
float tiot_output_floor_ms = 0.0f;
float tiot_predicted_temp_c = 0.0f;

/* Fast trajectory rate estimator. Keep the original slow estimator unchanged
 * because MODE_MT and full-power-rate learning also depend on it.
 */
float tiot_fast_rate_c_per_min = 0.0f;
float tiot_fast_rate_last_temp = 0.0f;
uint32_t tiot_fast_rate_last_time_ms = 0U;
bool tiot_fast_rate_initialized = false;

/* USER CODE END PV */

void SystemClock_Config(void);
static void MX_GPIO_Init(void);
static void MX_TIM2_Init(void);
static void MX_I2C2_Init(void);
static void MX_SPI1_Init(void);
static void MX_IWDG_Init(void);
/* USER CODE BEGIN PFP */
void Update_LCD(void);
void Process_Buttons(void);
void Init_Default_Intervals(void);
void Save_Settings_To_Flash(void);
void Load_Settings_From_Flash(void);
static void Copy_To_LCD_Row(char row[17], const char *text);
static void Update_Hold_Button_Events(uint32_t now_ms);
static void Update_Transient_UI(uint32_t now_ms);
static bool Is_Setting_UI_State(UIState_t state);
static uint32_t Interval_Duration_Seconds(uint8_t interval_index);
static void Sanitize_Settings(void);
static void Sanitize_Program(Stored_Program_t *program);
static void Commit_Pending_Edit(void);
static uint8_t Program_Manager_Saved_Count(void);
static uint8_t Program_Manager_Slot_At(uint8_t list_index);
static void Program_Manager_Keep_Selection_Visible(void);
static void Enter_Program_Manager(void);
static bool Load_Program_Slot(uint8_t slot);
static bool Save_Working_Program(uint8_t slot);
static bool Delete_Stored_Program(uint8_t slot);
static void Begin_Operation_Confirmation(ConfirmAction_t action, bool success,
                                         uint8_t slot, UIState_t return_state);
static void Stop_Heating_Control(void);
static void Stop_Profile_To_Idle(void);
static void Exit_To_Main_Idle(void);
static void Pause_Profile(void);
static bool Resume_Profile(void);
static bool Start_Profile(void);
static void Advance_Profile_If_Needed(uint32_t current_run_seconds);
static float Calculate_Profile_Setpoint(uint32_t current_run_seconds);
static float Calculate_TIOT_Control_Setpoint(uint32_t current_run_seconds,
                                             float profile_setpoint);
static void Update_TIOT_Rate_Estimate(void);
static void Reset_TIOT_Fast_Rate(uint32_t now_ms);
static void Update_TIOT_Fast_Rate(uint32_t now_ms);
static float Limit_TIOT_Output(float requested_output,
                               uint32_t current_run_seconds);
static void Reset_MT_Control(uint32_t now_ms);
static void Update_Temperature_Rate(uint32_t now_ms);
static void Apply_PID_Tunings(float kp, float ki, float kd);
static float MT_Hold_Output_Cap(float target_temp);
static float MT_Hold_Initial_Bias(float target_temp);
static void Update_MT_Control_Phase(float target_temp, float input_temp);
static float Limit_MT_Output(float requested_output, float target_temp, float input_temp);
static void Read_Temperature_Task(uint32_t now_ms);
static void Update_PID_And_SSR(uint32_t now_ms, uint32_t current_run_seconds);
static void Trip_Control_Fault(ControlFault_t fault);
static uint32_t Flash_Checksum_Bytes(const void *data, size_t count);
static uint32_t Flash_Checksum(const Flash_Data_t *data);
/* USER CODE END PFP */

/* USER CODE BEGIN 0 */
/**
  * @brief  EXTI Line Interrupt Callback
  * @note   Implements non-blocking software debounce.
  */
void HAL_GPIO_EXTI_Callback(uint16_t GPIO_Pin) {
    uint32_t current_time = HAL_GetTick();

    if (GPIO_Pin == GPIO_PIN_8 && (current_time - last_time_PA8 > DEBOUNCE_DELAY)) {
        button_setting_press = 1; last_time_PA8 = current_time;
    } else if (GPIO_Pin == GPIO_PIN_9 && (current_time - last_time_PA9 > DEBOUNCE_DELAY)) {
        button_redirect_press = 1; last_time_PA9 = current_time;
    } else if (GPIO_Pin == GPIO_PIN_15 && (current_time - last_time_PB15 > DEBOUNCE_DELAY)) {
        button_select_press = 1; last_time_PB15 = current_time;
    } else if (GPIO_Pin == GPIO_PIN_11 && (current_time - last_time_PA11 > DEBOUNCE_DELAY)) {
        button_tang = 1; last_time_PA11 = current_time;
    } else if (GPIO_Pin == GPIO_PIN_10 && (current_time - last_time_PA10 > DEBOUNCE_DELAY)) {
        button_giam = 1; last_time_PA10 = current_time;
    }
}

static void Update_Hold_Button_Events(uint32_t now_ms) {
    uint8_t setting_press_event;
    uint8_t redirect_press_event;
    uint8_t select_press_event;

    /* EXTI supplies the rising/pressed edge. Release is polled so no CubeMX
     * change to falling-edge interrupts is required.
     */
    uint32_t primask = __get_PRIMASK();
    __disable_irq();
    setting_press_event = button_setting_press;
    button_setting_press = 0U;
    redirect_press_event = button_redirect_press;
    button_redirect_press = 0U;
    select_press_event = button_select_press;
    button_select_press = 0U;
    if (primask == 0U) __enable_irq();

    if (setting_press_event != 0U) {
        setting_press_tracking = true;
        setting_long_emitted = false;
        setting_press_start_ms = last_time_PA8;
    }
    if (redirect_press_event != 0U) {
        redirect_press_tracking = true;
        redirect_long_emitted = false;
        redirect_press_start_ms = last_time_PA9;
    }
    if (select_press_event != 0U) {
        select_press_tracking = true;
        select_long_emitted = false;
        select_press_start_ms = last_time_PB15;
    }

    if (setting_press_tracking) {
        const bool pressed =
            (HAL_GPIO_ReadPin(GPIOA, GPIO_PIN_8) == GPIO_PIN_SET);
        const uint32_t held_ms = now_ms - setting_press_start_ms;

        if (pressed && !setting_long_emitted &&
            held_ms >= BUTTON_LONG_PRESS_MS) {
            button_setting_long = 1U;
            setting_long_emitted = true;
        } else if (!pressed) {
            if (!setting_long_emitted) button_setting = 1U;
            setting_press_tracking = false;
            setting_long_emitted = false;
        }
    }

    if (redirect_press_tracking) {
        const bool pressed =
            (HAL_GPIO_ReadPin(GPIOA, GPIO_PIN_9) == GPIO_PIN_SET);
        const uint32_t held_ms = now_ms - redirect_press_start_ms;

        if (pressed && !redirect_long_emitted &&
            held_ms >= BUTTON_LONG_PRESS_MS) {
            button_redirect_long = 1U;
            redirect_long_emitted = true;
        } else if (!pressed) {
            if (!redirect_long_emitted) button_redirect = 1U;
            redirect_press_tracking = false;
            redirect_long_emitted = false;
        }
    }

    if (select_press_tracking) {
        const bool pressed =
            (HAL_GPIO_ReadPin(GPIOB, GPIO_PIN_15) == GPIO_PIN_SET);
        const uint32_t held_ms = now_ms - select_press_start_ms;

        if (pressed && !select_long_emitted &&
            held_ms >= BUTTON_LONG_PRESS_MS) {
            button_select_long = 1U;
            select_long_emitted = true;
        } else if (!pressed) {
            if (!select_long_emitted) button_select = 1U;
            select_press_tracking = false;
            select_long_emitted = false;
        }
    }
}

static bool Is_Setting_UI_State(UIState_t state) {
    return (state == UI_STATE_SET_INTERVAL) ||
           (state == UI_STATE_SET_P) ||
           (state == UI_STATE_SET_TEMP) ||
           (state == UI_STATE_SET_TIME);
}

static void Update_Transient_UI(uint32_t now_ms) {
    if (Current_UI_State == UI_STATE_OPERATION_CONFIRM &&
        (int32_t)(now_ms - Confirmation_Until_Ms) >= 0) {
        Current_UI_State = Confirmation_Return_State;
        LCD_Needs_Update = true;
    }
}

/**
  * @brief  Timer Period Elapsed Callback (1Hz Real-Time Clock)
  * @note   Only increments time if the system is explicitly in the RUNNING state.
  */
void HAL_TIM_PeriodElapsedCallback(TIM_HandleTypeDef *htim) {
    if (htim->Instance == TIM2) {
        if (System_Run_State == SYS_RUNNING && Control_Fault == CONTROL_FAULT_NONE) {
            Run_Total_Seconds++;
            // Trigger an LCD refresh every second so the clock UI updates smoothly.
            if (Current_UI_State == UI_STATE_MAIN) {
                LCD_Needs_Update = true;
            }
        }
    }
}

static void Copy_To_LCD_Row(char row[17], const char *text) {
    size_t length = strlen(text);
    if (length > 16U) length = 16U;
    memcpy(row, text, length);
}

static uint32_t Interval_Duration_Seconds(uint8_t interval_index) {
    if (interval_index >= MAX_INTERVALS) return 0U;

    return ((uint32_t)Intervals[interval_index].Time_Hour * 3600U) +
           ((uint32_t)Intervals[interval_index].Time_Min * 60U) +
           (uint32_t)Intervals[interval_index].Time_Sec;
}

static void Sanitize_Settings(void) {
    if (Total_Intervals < 1U || Total_Intervals > MAX_INTERVALS) {
        Total_Intervals = 1U;
    }

    for (uint8_t i = 0U; i < MAX_INTERVALS; i++) {
        if (Intervals[i].Mode != MODE_MT && Intervals[i].Mode != MODE_TIOT) {
            Intervals[i].Mode = MODE_MT;
        }
        if (Intervals[i].Temp > PROCESS_MAX_TEMP_C) {
            Intervals[i].Temp = PROCESS_MAX_TEMP_C;
        }
        if (Intervals[i].Time_Min > 59U) Intervals[i].Time_Min = 59U;
        if (Intervals[i].Time_Sec > 59U) Intervals[i].Time_Sec = 59U;
    }
}

static void Sanitize_Program(Stored_Program_t *program) {
    if (program == NULL) return;

    if (program->TotalIntervals < 1U ||
        program->TotalIntervals > MAX_INTERVALS) {
        program->TotalIntervals = 1U;
    }

    for (uint8_t i = 0U; i < MAX_INTERVALS; i++) {
        if (program->Intervals[i].Mode != MODE_MT &&
            program->Intervals[i].Mode != MODE_TIOT) {
            program->Intervals[i].Mode = MODE_MT;
        }
        if (program->Intervals[i].Temp > PROCESS_MAX_TEMP_C) {
            program->Intervals[i].Temp = PROCESS_MAX_TEMP_C;
        }
        if (program->Intervals[i].Time_Min > 59U) {
            program->Intervals[i].Time_Min = 59U;
        }
        if (program->Intervals[i].Time_Sec > 59U) {
            program->Intervals[i].Time_Sec = 59U;
        }
    }
}

static void Commit_Pending_Edit(void) {
    if (Setting_P_Index < 1U || Setting_P_Index > Total_Intervals) return;

    if (Current_UI_State == UI_STATE_SET_TEMP) {
        if (Temp_Edit_Val > PROCESS_MAX_TEMP_C) Temp_Edit_Val = PROCESS_MAX_TEMP_C;
        Intervals[Setting_P_Index - 1U].Temp = Temp_Edit_Val;
    } else if (Current_UI_State == UI_STATE_SET_TIME) {
        if (Time_Edit_M > 59U) Time_Edit_M = 59U;
        if (Time_Edit_S > 59U) Time_Edit_S = 59U;
        Intervals[Setting_P_Index - 1U].Time_Hour = Time_Edit_H;
        Intervals[Setting_P_Index - 1U].Time_Min = Time_Edit_M;
        Intervals[Setting_P_Index - 1U].Time_Sec = Time_Edit_S;
    }
}

static uint8_t Program_Manager_Saved_Count(void) {
    uint8_t count = 0U;
    for (uint8_t i = 0U; i < MAX_PROGRAMS; i++) {
        if (Stored_Programs[i].ValidMarker == PROGRAM_VALID_MARKER) count++;
    }
    return count;
}

static uint8_t Program_Manager_Slot_At(uint8_t list_index) {
    uint8_t found = 0U;

    for (uint8_t slot = 0U; slot < MAX_PROGRAMS; slot++) {
        if (Stored_Programs[slot].ValidMarker != PROGRAM_VALID_MARKER) continue;
        if (found == list_index) return slot;
        found++;
    }
    return NO_PROGRAM_SLOT;
}

static void Program_Manager_Keep_Selection_Visible(void) {
    const uint8_t count = Program_Manager_Saved_Count();
    if (count == 0U) {
        Program_Manager_Selection = 0U;
        Program_Manager_Top = 0U;
        return;
    }

    if (Program_Manager_Selection >= count) Program_Manager_Selection = 0U;
    if (Program_Manager_Selection < Program_Manager_Top) {
        Program_Manager_Top = Program_Manager_Selection;
    } else if (Program_Manager_Selection >=
               (uint8_t)(Program_Manager_Top + 2U)) {
        Program_Manager_Top = Program_Manager_Selection - 1U;
    }

    const uint8_t maximum_top = (count > 2U) ? (count - 2U) : 0U;
    if (Program_Manager_Top > maximum_top) Program_Manager_Top = maximum_top;
}

static void Enter_Program_Manager(void) {
    Stop_Profile_To_Idle();
    Editing_From_Program_Manager = false;
    Working_Program_Slot = NO_PROGRAM_SLOT;
    Program_Manager_Selection = 0U;
    Program_Manager_Top = 0U;
    Current_UI_State = UI_STATE_PROGRAM_MANAGER;
    LCD_Needs_Update = true;
}

static bool Load_Program_Slot(uint8_t slot) {
    if (slot >= MAX_PROGRAMS ||
        Stored_Programs[slot].ValidMarker != PROGRAM_VALID_MARKER) {
        return false;
    }

    Total_Intervals = (uint8_t)Stored_Programs[slot].TotalIntervals;
    memcpy(Intervals, Stored_Programs[slot].Intervals, sizeof(Intervals));
    Sanitize_Settings();
    Active_Program_Slot = slot;
    Working_Program_Slot = slot;
    return true;
}

static bool Save_Working_Program(uint8_t slot) {
    if (slot >= MAX_PROGRAMS) return false;

    Sanitize_Settings();
    program_rollback_data = Stored_Programs[slot];
    const uint8_t previous_active_slot = Active_Program_Slot;
    const uint8_t previous_working_slot = Working_Program_Slot;

    Stored_Programs[slot].ValidMarker = PROGRAM_VALID_MARKER;
    Stored_Programs[slot].TotalIntervals = (uint32_t)Total_Intervals;
    memcpy(Stored_Programs[slot].Intervals, Intervals, sizeof(Intervals));
    Active_Program_Slot = slot;
    Working_Program_Slot = slot;
    Save_Settings_To_Flash();

    if (!flash_write_ok) {
        Stored_Programs[slot] = program_rollback_data;
        Active_Program_Slot = previous_active_slot;
        Working_Program_Slot = previous_working_slot;
        return false;
    }
    return true;
}

static bool Delete_Stored_Program(uint8_t slot) {
    if (slot >= MAX_PROGRAMS ||
        Stored_Programs[slot].ValidMarker != PROGRAM_VALID_MARKER) {
        return false;
    }

    program_rollback_data = Stored_Programs[slot];
    const uint8_t previous_active_slot = Active_Program_Slot;
    const uint8_t previous_working_slot = Working_Program_Slot;

    memset(&Stored_Programs[slot], 0, sizeof(Stored_Programs[slot]));
    if (Active_Program_Slot == slot) Active_Program_Slot = NO_PROGRAM_SLOT;
    if (Working_Program_Slot == slot) Working_Program_Slot = NO_PROGRAM_SLOT;
    Save_Settings_To_Flash();

    if (!flash_write_ok) {
        Stored_Programs[slot] = program_rollback_data;
        Active_Program_Slot = previous_active_slot;
        Working_Program_Slot = previous_working_slot;
        return false;
    }
    return true;
}

static void Begin_Operation_Confirmation(ConfirmAction_t action, bool success,
                                         uint8_t slot, UIState_t return_state) {
    Confirmation_Action = action;
    Confirmation_Success = success;
    Confirmation_Program_Slot = slot;
    Confirmation_Return_State = return_state;
    Confirmation_Until_Ms = HAL_GetTick() + OPERATION_CONFIRM_DISPLAY_MS;
    Current_UI_State = UI_STATE_OPERATION_CONFIRM;
    LCD_Needs_Update = true;
}

static void Stop_Heating_Control(void) {
    HAL_GPIO_WritePin(GPIOB, GPIO_PIN_7, GPIO_PIN_RESET);
    if (PID_GetMode(&pid_heater) != PID_MANUAL) {
        PID_SetMode(&pid_heater, PID_MANUAL);
    }
    Output = 0.0f;
    active_output = 0.0f;
    pid_heater.outputSum = 0.0f;
    mt_control_phase = MT_PHASE_APPROACH;
    mt_predicted_temp_c = Input;
    mt_output_limit_ms = 0.0f;
    mt_precoast_output_ms = 0.0f;
    last_control_interval = 0U;
    last_control_mode = 0xFFU;

    tiot_ideal_temp_c = Input;
    tiot_command_setpoint_c = Input;
    tiot_planned_rate_c_per_min = 0.0f;
    tiot_required_rate_c_per_min = 0.0f;
    tiot_output_floor_ms = 0.0f;
    tiot_predicted_temp_c = Input;
}

static void Stop_Profile_To_Idle(void) {
    /* Stop the actuator first, then atomically reset the scheduler clock/state
     * shared with the 1 Hz TIM2 interrupt. UI_STATE_MAIN renders SYS_IDLE as
     * P0/... and Run_Total_Seconds == 0 as 00:00:00.
     */
    HAL_GPIO_WritePin(GPIOB, GPIO_PIN_7, GPIO_PIN_RESET);

    uint32_t primask = __get_PRIMASK();
    __disable_irq();
    System_Run_State = SYS_IDLE;
    Run_Total_Seconds = 0U;
    Current_Interval = 1U;
    Current_Interval_Start_Sec = 0U;
    Target_Run_Seconds = 0U;
    if (primask == 0U) __enable_irq();

    Current_Interval_Start_Temp = Input;
    paused_pid_output_sum = 0.0f;
    paused_active_output_ms = 0.0f;
    Stop_Heating_Control();
}

static void Exit_To_Main_Idle(void) {
    Stop_Profile_To_Idle();
    Editing_From_Program_Manager = false;
    Working_Program_Slot = NO_PROGRAM_SLOT;
    Current_UI_State = UI_STATE_MAIN;
    LCD_Needs_Update = true;
}

static void Pause_Profile(void) {
    if (System_Run_State != SYS_RUNNING) return;

    /* Capture the controller state before suppressing the physical output.
     * Run_Total_Seconds is frozen by the TIM2 callback once SYS_PAUSED is set.
     */
    paused_pid_output_sum = pid_heater.outputSum;
    paused_active_output_ms = active_output;

    uint32_t primask = __get_PRIMASK();
    __disable_irq();
    System_Run_State = SYS_PAUSED;
    if (primask == 0U) __enable_irq();

    HAL_GPIO_WritePin(GPIOB, GPIO_PIN_7, GPIO_PIN_RESET);
    if (PID_GetMode(&pid_heater) != PID_MANUAL) {
        PID_SetMode(&pid_heater, PID_MANUAL);
    }
    Output = 0.0f;
    active_output = 0.0f;
    windowStartTime = HAL_GetTick();
}

static bool Resume_Profile(void) {
    if (System_Run_State != SYS_PAUSED ||
        Control_Fault != CONTROL_FAULT_NONE ||
        !sensor_has_valid_sample) {
        return false;
    }

    const uint32_t now_ms = HAL_GetTick();

    /* Restore the stored integral after PID_SetMode() performs its normal
     * manual-to-auto initialization. Reset derivative history to the current
     * temperature so cooling during a long pause cannot create a kick.
     */
    Output = paused_active_output_ms;
    PID_SetMode(&pid_heater, PID_AUTOMATIC);
    pid_heater.outputSum = paused_pid_output_sum;
    if (pid_heater.outputSum < 0.0f) pid_heater.outputSum = 0.0f;
    if (pid_heater.outputSum > (float)WINDOW_SIZE) {
        pid_heater.outputSum = (float)WINDOW_SIZE;
    }
    pid_heater.lastInput = Input;
    pid_heater.lastTime = now_ms - pid_heater.SampleTime;

    /* Start a new slow-PWM window with the output still physically OFF. The
     * regular control task computes the resumed demand in this same main loop.
     */
    Output = 0.0f;
    active_output = 0.0f;
    windowStartTime = now_ms;
    HAL_GPIO_WritePin(GPIOB, GPIO_PIN_7, GPIO_PIN_RESET);

    uint32_t primask = __get_PRIMASK();
    __disable_irq();
    System_Run_State = SYS_RUNNING;
    if (primask == 0U) __enable_irq();
    return true;
}

static void Trip_Control_Fault(ControlFault_t fault) {
    if (fault == CONTROL_FAULT_NONE) return;

    Control_Fault = fault;
    System_Run_State = SYS_IDLE;
    Stop_Heating_Control();
    LCD_Needs_Update = true;
}

static bool Start_Profile(void) {
    Sanitize_Settings();

    if (Control_Fault != CONTROL_FAULT_NONE || !sensor_has_valid_sample) {
        if (!sensor_has_valid_sample && Control_Fault == CONTROL_FAULT_NONE) {
            Control_Fault = CONTROL_FAULT_SENSOR_DATA;
        }
        System_Run_State = SYS_IDLE;
        Stop_Heating_Control();
        return false;
    }

    uint32_t primask = __get_PRIMASK();
    __disable_irq();
    Run_Total_Seconds = 0U;
    Current_Interval = 1U;
    Current_Interval_Start_Sec = 0U;
    Current_Interval_Start_Temp = Input;
    Target_Run_Seconds = Interval_Duration_Seconds(0U);
    System_Run_State = SYS_RUNNING;
    if (primask == 0U) __enable_irq();

    Setpoint = Input;
    last_setpoint = Setpoint;
    Output = 0.0f;
    active_output = 0.0f;
    pid_heater.outputSum = 0.0f;
    pid_heater.lastInput = Input;
    pid_heater.lastTime = HAL_GetTick() - pid_heater.SampleTime;
    Apply_PID_Tunings(MT_APPROACH_KP, 0.0f, MT_APPROACH_KD);
    ki_is_active = false;
    windowStartTime = HAL_GetTick();
    tiot_full_power_rate_est_c_per_min = TIOT_INITIAL_FULL_POWER_RATE_C_MIN;
    tiot_ideal_temp_c = Input;
    tiot_command_setpoint_c = Input;
    tiot_planned_rate_c_per_min = 0.0f;
    tiot_required_rate_c_per_min = 0.0f;
    tiot_output_floor_ms = 0.0f;
    tiot_predicted_temp_c = Input;
    Reset_TIOT_Fast_Rate(windowStartTime);
    Reset_MT_Control(windowStartTime);

    /* Immediately skip any zero-duration segments without heating them. */
    Advance_Profile_If_Needed(0U);
    return (System_Run_State == SYS_RUNNING);
}

static void Advance_Profile_If_Needed(uint32_t current_run_seconds) {
    uint8_t guard = 0U;

    /* Fixed-time scheduler:
     * A segment ends only because its programmed time has elapsed. TIOT never
     * extends the timeline waiting for temperature to enter a tolerance band.
     * Using the scheduled Target_Run_Seconds as the next boundary also prevents
     * any main-loop latency from accumulating from segment to segment.
     */
    while (System_Run_State == SYS_RUNNING &&
           current_run_seconds >= Target_Run_Seconds &&
           guard < MAX_INTERVALS) {
        const uint8_t finished_index = Current_Interval - 1U;
        const uint32_t boundary_time = Target_Run_Seconds;
        guard++;

        if (Current_Interval < Total_Intervals) {
            Current_Interval++;
            Current_Interval_Start_Sec = boundary_time;

            /* Start the next trajectory from the actual measured temperature at
             * the fixed transition instant. No time from the finished interval
             * is carried forward or added to the next interval.
             */
            Current_Interval_Start_Temp =
                sensor_has_valid_sample ? Input
                                        : (float)Intervals[finished_index].Temp;

            Target_Run_Seconds = boundary_time +
                Interval_Duration_Seconds(Current_Interval - 1U);
            LCD_Needs_Update = true;
        } else {
            System_Run_State = SYS_COMPLETED;
            Stop_Heating_Control();
            LCD_Needs_Update = true;
        }
    }
}

static float Calculate_Profile_Setpoint(uint32_t current_run_seconds) {
    const uint8_t index = Current_Interval - 1U;
    const float target_temp = (float)Intervals[index].Temp;

    if (Intervals[index].Mode == MODE_MT) {
        return target_temp;
    }

    const uint32_t duration = Interval_Duration_Seconds(index);
    if (duration == 0U) return target_temp;

    uint32_t elapsed = current_run_seconds - Current_Interval_Start_Sec;
    if (elapsed > duration) elapsed = duration;

    const float fraction = (float)elapsed / (float)duration;
    float ramp_setpoint = Current_Interval_Start_Temp +
                          ((target_temp - Current_Interval_Start_Temp) * fraction);

    if (ramp_setpoint < 0.0f) ramp_setpoint = 0.0f;
    if (ramp_setpoint > (float)PROCESS_MAX_TEMP_C) ramp_setpoint = (float)PROCESS_MAX_TEMP_C;
    return ramp_setpoint;
}



static float Calculate_TIOT_Control_Setpoint(uint32_t current_run_seconds,
                                             float profile_setpoint) {
    const uint8_t index = Current_Interval - 1U;
    const float target_temp = (float)Intervals[index].Temp;
    const uint32_t duration_sec = Interval_Duration_Seconds(index);

    tiot_ideal_temp_c = profile_setpoint;
    tiot_planned_rate_c_per_min = 0.0f;
    tiot_required_rate_c_per_min = 0.0f;

    if (duration_sec == 0U ||
        target_temp <= Current_Interval_Start_Temp) {
        tiot_command_setpoint_c = target_temp;
        return target_temp;
    }

    const uint32_t remaining_sec =
        (Target_Run_Seconds > current_run_seconds)
            ? (Target_Run_Seconds - current_run_seconds)
            : 0U;
    tiot_planned_rate_c_per_min =
        ((target_temp - Current_Interval_Start_Temp) * 60.0f) /
        (float)duration_sec;

    /* Correct deviations back to the programmed line over a bounded horizon.
     * This is deliberately based on profile_setpoint - Input, not on the final
     * target divided by remaining time. Therefore the controller cannot ignore
     * the intermediate linear trajectory and race toward the endpoint early.
     */
    float correction_time_min = (float)remaining_sec / 60.0f;
    if (correction_time_min > TIOT_TRACK_CORRECTION_MAX_MIN) {
        correction_time_min = TIOT_TRACK_CORRECTION_MAX_MIN;
    }
    if (correction_time_min < TIOT_TRACK_CORRECTION_MIN_MIN) {
        correction_time_min = TIOT_TRACK_CORRECTION_MIN_MIN;
    }

    const float pace_error = profile_setpoint - Input;
    tiot_required_rate_c_per_min =
        tiot_planned_rate_c_per_min +
        (pace_error / correction_time_min);

    if (tiot_required_rate_c_per_min > TIOT_RATE_EST_MAX_FULL_C_MIN) {
        tiot_required_rate_c_per_min = TIOT_RATE_EST_MAX_FULL_C_MIN;
    }
    if (tiot_required_rate_c_per_min < 0.0f) {
        tiot_required_rate_c_per_min = 0.0f;
    }

    /* The PID Setpoint is exactly the ideal ramp. No positive lead is allowed. */
    float command_setpoint = profile_setpoint;
    if (command_setpoint > target_temp) command_setpoint = target_temp;
    if (command_setpoint < 0.0f) command_setpoint = 0.0f;
    if (command_setpoint > (float)PROCESS_MAX_TEMP_C) {
        command_setpoint = (float)PROCESS_MAX_TEMP_C;
    }

    tiot_command_setpoint_c = command_setpoint;
    return command_setpoint;
}

static void Update_TIOT_Rate_Estimate(void) {
    if (System_Run_State != SYS_RUNNING ||
        last_control_mode != MODE_TIOT ||
        active_output < TIOT_RATE_EST_MIN_OUTPUT_MS ||
        temp_rate_c_per_min < TIOT_RATE_EST_MIN_C_MIN) {
        return;
    }

    const uint8_t index = Current_Interval - 1U;
    const uint32_t interval_elapsed_sec =
        Run_Total_Seconds - Current_Interval_Start_Sec;
    const float target_error = (float)Intervals[index].Temp - Input;

    /* Ignore startup thermal delay and final coasting. Otherwise stored heat
     * would be incorrectly interpreted as the instantaneous heater gain.
     */
    if (interval_elapsed_sec < TIOT_RATE_EST_WARMUP_SEC ||
        target_error <= TIOT_RATE_EST_FREEZE_BAND_C) {
        return;
    }

    float observed_full_rate =
        temp_rate_c_per_min * ((float)WINDOW_SIZE / active_output);

    if (!isfinite(observed_full_rate)) return;
    if (observed_full_rate < TIOT_RATE_EST_MIN_FULL_C_MIN) {
        observed_full_rate = TIOT_RATE_EST_MIN_FULL_C_MIN;
    } else if (observed_full_rate > TIOT_RATE_EST_MAX_FULL_C_MIN) {
        observed_full_rate = TIOT_RATE_EST_MAX_FULL_C_MIN;
    }

    tiot_full_power_rate_est_c_per_min +=
        TIOT_RATE_EST_ALPHA *
        (observed_full_rate - tiot_full_power_rate_est_c_per_min);
}

static void Reset_TIOT_Fast_Rate(uint32_t now_ms) {
    tiot_fast_rate_c_per_min = 0.0f;
    tiot_fast_rate_last_temp = Input;
    tiot_fast_rate_last_time_ms = now_ms;
    tiot_fast_rate_initialized = sensor_has_valid_sample && isfinite(Input);
}

static void Update_TIOT_Fast_Rate(uint32_t now_ms) {
    if (!sensor_has_valid_sample || !isfinite(Input)) return;

    if (!tiot_fast_rate_initialized) {
        Reset_TIOT_Fast_Rate(now_ms);
        return;
    }

    const uint32_t elapsed_ms = now_ms - tiot_fast_rate_last_time_ms;
    if (elapsed_ms < TIOT_FAST_RATE_UPDATE_MS) return;

    const float elapsed_min = (float)elapsed_ms / 60000.0f;
    if (elapsed_min <= 0.0f) return;

    float instant_rate =
        (Input - tiot_fast_rate_last_temp) / elapsed_min;
    if (!isfinite(instant_rate)) instant_rate = 0.0f;

    if (instant_rate > TIOT_FAST_RATE_MAX_ABS_C_MIN) {
        instant_rate = TIOT_FAST_RATE_MAX_ABS_C_MIN;
    } else if (instant_rate < -TIOT_FAST_RATE_MAX_ABS_C_MIN) {
        instant_rate = -TIOT_FAST_RATE_MAX_ABS_C_MIN;
    }

    tiot_fast_rate_c_per_min +=
        TIOT_FAST_RATE_ALPHA *
        (instant_rate - tiot_fast_rate_c_per_min);
    tiot_fast_rate_last_temp = Input;
    tiot_fast_rate_last_time_ms = now_ms;
}

static float Limit_TIOT_Output(float requested_output,
                               uint32_t current_run_seconds) {
    const uint8_t index = Current_Interval - 1U;
    const float target_temp = (float)Intervals[index].Temp;
    const uint32_t duration_sec = Interval_Duration_Seconds(index);
    const uint32_t remaining_sec =
        (Target_Run_Seconds > current_run_seconds)
            ? (Target_Run_Seconds - current_run_seconds)
            : 0U;

    /* PID uses filtered Input for stability. Endpoint protection uses the hotter
     * of filtered/raw readings so positive sensor-filter lag cannot add energy.
     */
    float safety_temp = Input;
    if (isfinite(raw_temp) && raw_temp > safety_temp) safety_temp = raw_temp;

    const float target_error = target_temp - safety_temp;
    const float pace_error = tiot_ideal_temp_c - Input;
    float measured_rate = temp_rate_c_per_min;
    if (!isfinite(measured_rate)) measured_rate = 0.0f;

    const float slow_positive_rate =
        (measured_rate > 0.0f) ? measured_rate : 0.0f;
    const float fast_positive_rate =
        (tiot_fast_rate_c_per_min > 0.0f) ? tiot_fast_rate_c_per_min : 0.0f;

    if (duration_sec == 0U || target_temp <= Current_Interval_Start_Temp) {
        if (safety_temp >= target_temp) {
            Output = 0.0f;
            pid_heater.outputSum = 0.0f;
            tiot_output_floor_ms = 0.0f;
            return 0.0f;
        }
        return requested_output;
    }

    /* Never add heat at/above the final target. The hotter raw/filtered sample
     * wins, so sensor-filter lag cannot issue one extra SSR pulse.
     */
    if (target_error <= 0.0f ||
        safety_temp >= (target_temp + TIOT_HARD_CUTOFF_C)) {
        Output = 0.0f;
        pid_heater.outputSum = 0.0f;
        tiot_output_floor_ms = 0.0f;
        tiot_predicted_temp_c = safety_temp;
        return 0.0f;
    }

    float rate_est = tiot_full_power_rate_est_c_per_min;
    if (!isfinite(rate_est)) {
        rate_est = TIOT_INITIAL_FULL_POWER_RATE_C_MIN;
    }
    if (rate_est < TIOT_RATE_EST_MIN_FULL_C_MIN) {
        rate_est = TIOT_RATE_EST_MIN_FULL_C_MIN;
    } else if (rate_est > TIOT_RATE_EST_MAX_FULL_C_MIN) {
        rate_est = TIOT_RATE_EST_MAX_FULL_C_MIN;
    }

    /* Feed-forward follows the rate required to return to the programmed line,
     * not the rate required to race directly to the final target.
     */
    float rate_feedforward_ms =
        (tiot_required_rate_c_per_min / rate_est) *
        (float)WINDOW_SIZE;

    if (rate_feedforward_ms < 0.0f) rate_feedforward_ms = 0.0f;
    if (rate_feedforward_ms > (float)WINDOW_SIZE) {
        rate_feedforward_ms = (float)WINDOW_SIZE;
    }

    /* Signed rate feedback is the damping term. It adds power while the actual
     * slope is too low and removes power while the furnace is accelerating too
     * quickly. Unlike the old positive-only floor, it can actively correct an
     * ahead-of-profile condition.
     */
    const float rate_error =
        tiot_required_rate_c_per_min - measured_rate;
    float limited_output = rate_feedforward_ms +
        (rate_error * TIOT_RATE_FEEDBACK_MS_PER_C_MIN);

    if (limited_output < 0.0f) limited_output = 0.0f;
    if (limited_output > (float)WINDOW_SIZE) {
        limited_output = (float)WINDOW_SIZE;
    }

    /* Short receding-horizon guard against running ahead of the linear ramp.
     * Compare predicted furnace temperature with the future ramp reference at
     * the same instant. If predicted ahead, proportionally reduce the SSR duty;
     * one full brake band ahead means SSR OFF. Near timeout, future_reference is
     * clamped to the final target, so the same guard also prevents powered
     * overshoot beyond Setpoint without aiming below Setpoint.
     */
    float lookahead_min = (float)remaining_sec / 60.0f;
    if (lookahead_min > TIOT_TRAJECTORY_LOOKAHEAD_MIN) {
        lookahead_min = TIOT_TRAJECTORY_LOOKAHEAD_MIN;
    }
    if (lookahead_min < 0.0f) lookahead_min = 0.0f;

    const float prediction_rate =
        (fast_positive_rate > slow_positive_rate)
            ? fast_positive_rate
            : slow_positive_rate;
    tiot_predicted_temp_c = safety_temp +
        (prediction_rate * lookahead_min);

    float future_reference = tiot_ideal_temp_c +
        (tiot_planned_rate_c_per_min * lookahead_min);
    if (future_reference > target_temp) future_reference = target_temp;

    const float predicted_ahead_c =
        tiot_predicted_temp_c - future_reference;
    if (predicted_ahead_c > 0.0f) {
        float brake_fraction = 1.0f -
            (predicted_ahead_c / TIOT_TRAJECTORY_BRAKE_BAND_C);
        if (brake_fraction < 0.0f) brake_fraction = 0.0f;
        limited_output *= brake_fraction;
    }

    tiot_output_floor_ms = rate_feedforward_ms;

    /* Avoid unusable sub-deadband pulses, but keep one useful pulse when the
     * actual temperature is behind the programmed line.
     */
    if (limited_output > 0.0f && limited_output < TIOT_MIN_USEFUL_PULSE_MS) {
        if (pace_error > TIOT_TARGET_TOLERANCE_C &&
            target_error > TIOT_TARGET_TOLERANCE_C) {
            limited_output = TIOT_MIN_USEFUL_PULSE_MS;
        } else {
            limited_output = 0.0f;
        }
    }

    if (limited_output < 0.0f) limited_output = 0.0f;
    if (limited_output > (float)WINDOW_SIZE) {
        limited_output = (float)WINDOW_SIZE;
    }

    /* Align the PID-visible state with the actuator command. This controller is
     * the TIOT outer loop; MT resets/reseeds PID on mode entry as before.
     */
    Output = limited_output;
    pid_heater.outputSum = limited_output;
    return limited_output;
}

static void Reset_MT_Control(uint32_t now_ms) {
    mt_control_phase = MT_PHASE_APPROACH;
    mt_predicted_temp_c = Input;
    mt_output_limit_ms = 0.0f;
    mt_precoast_output_ms = 0.0f;

    temp_rate_c_per_min = 0.0f;
    temp_rate_last_temp = Input;
    temp_rate_last_time_ms = now_ms;
    temp_rate_initialized = sensor_has_valid_sample && isfinite(Input);

    last_control_interval = 0U;
    last_control_mode = 0xFFU;
}

static void Update_Temperature_Rate(uint32_t now_ms) {
    if (!sensor_has_valid_sample || !isfinite(Input)) return;

    if (!temp_rate_initialized) {
        temp_rate_c_per_min = 0.0f;
        temp_rate_last_temp = Input;
        temp_rate_last_time_ms = now_ms;
        temp_rate_initialized = true;
        return;
    }

    const uint32_t elapsed_ms = now_ms - temp_rate_last_time_ms;
    if (elapsed_ms < TEMP_RATE_UPDATE_MS) return;

    const float elapsed_min = (float)elapsed_ms / 60000.0f;
    if (elapsed_min <= 0.0f) return;

    float instant_rate = (Input - temp_rate_last_temp) / elapsed_min;
    if (!isfinite(instant_rate)) instant_rate = 0.0f;

    if (instant_rate > TEMP_RATE_MAX_ABS_C_PER_MIN) {
        instant_rate = TEMP_RATE_MAX_ABS_C_PER_MIN;
    } else if (instant_rate < -TEMP_RATE_MAX_ABS_C_PER_MIN) {
        instant_rate = -TEMP_RATE_MAX_ABS_C_PER_MIN;
    }

    temp_rate_c_per_min +=
        TEMP_RATE_FILTER_ALPHA * (instant_rate - temp_rate_c_per_min);
    temp_rate_last_temp = Input;
    temp_rate_last_time_ms = now_ms;
    Update_TIOT_Rate_Estimate();
}

static void Apply_PID_Tunings(float kp, float ki, float kd) {
    const bool changed =
        (fabsf(PID_GetKp(&pid_heater) - kp) > 0.0001f) ||
        (fabsf(PID_GetKi(&pid_heater) - ki) > 0.0001f) ||
        (fabsf(PID_GetKd(&pid_heater) - kd) > 0.0001f);

    if (changed) {
        PID_SetTunings(&pid_heater, kp, ki, kd, PID_P_ON_E);
    }
    ki_is_active = (ki > 0.0f);
}

static float MT_Hold_Output_Cap(float target_temp) {
    /* Heat loss rises strongly with furnace temperature. This adaptive ceiling
     * avoids an unrealistically small hold duty at high Setpoints while still
     * limiting stored heat at low Setpoints.
     */
    float cap_ms = 180.0f + (0.45f * target_temp);
    if (cap_ms < 250.0f) cap_ms = 250.0f;
    if (cap_ms > 850.0f) cap_ms = 850.0f;

    /* A fixed temperature-only ceiling can be lower than the real heat-loss
     * duty of a particular load. Reuse the actuator demand that was already
     * proven immediately before MT (especially the TIOT -> MT transition), so
     * HOLD is not mathematically prevented from maintaining Setpoint.
     */
    if (mt_precoast_output_ms > cap_ms) {
        cap_ms = mt_precoast_output_ms;
    }
    if (cap_ms > (float)WINDOW_SIZE) cap_ms = (float)WINDOW_SIZE;
    return cap_ms;
}

static float MT_Hold_Initial_Bias(float target_temp) {
    /* Do not enter HOLD with an almost-empty integral.
     *
     * mt_precoast_output_ms remembers the latest useful approach/coast demand.
     * The second term provides a conservative temperature-dependent loss bias
     * even when HOLD is entered directly from APPROACH.
     */
    const float hold_cap = MT_Hold_Output_Cap(target_temp);
    float bias_from_previous = mt_precoast_output_ms * MT_HOLD_BIAS_FRACTION;
    float bias_from_loss = hold_cap * MT_HOLD_BIAS_CAP_FRACTION;
    float initial_bias =
        (bias_from_previous > bias_from_loss) ? bias_from_previous : bias_from_loss;

    if (initial_bias > hold_cap) initial_bias = hold_cap;
    if (initial_bias < 0.0f) initial_bias = 0.0f;
    return initial_bias;
}

static void Enter_MT_Phase(MTControlPhase_t new_phase, float target_temp) {
    if (new_phase == mt_control_phase) return;

    if (new_phase == MT_PHASE_COAST) {
        /* Preserve the strongest recently-proven hold demand. In particular,
         * do not replace the TIOT handover duty with the smaller startup bias
         * if residual heat immediately sends the new MT interval to COAST.
         */
        if (active_output > mt_precoast_output_ms) {
            mt_precoast_output_ms = active_output;
        }
        Output = 0.0f;
        active_output = 0.0f;
        pid_heater.outputSum = 0.0f;
    } else if (new_phase == MT_PHASE_APPROACH) {
        Output = 0.0f;
        active_output = 0.0f;
        pid_heater.outputSum = 0.0f;
    } else { /* MT_PHASE_HOLD */
        const float initial_bias = MT_Hold_Initial_Bias(target_temp);
        pid_heater.outputSum = initial_bias;
        Output = initial_bias;
        active_output = initial_bias;
        pid_heater.lastInput = Input;
        pid_heater.lastTime = HAL_GetTick() - pid_heater.SampleTime;
    }

    mt_control_phase = new_phase;
}

static void Update_MT_Control_Phase(float target_temp, float input_temp) {
    const float error = target_temp - input_temp;
    const float rising_rate =
        (temp_rate_c_per_min > 0.0f) ? temp_rate_c_per_min : 0.0f;

    mt_predicted_temp_c = input_temp +
                          (rising_rate * MT_THERMAL_LOOKAHEAD_MIN);

    switch (mt_control_phase) {
        case MT_PHASE_APPROACH:
            /* Actual over-temperature always has highest priority. */
            if (input_temp >= (target_temp + MT_HARD_CUTOFF_C) ||
                raw_temp >= (target_temp + MT_HARD_CUTOFF_C)) {
                Enter_MT_Phase(MT_PHASE_COAST, target_temp);
            }
            /* Predictive coast is only allowed very near target.  This removes
             * the old failure mode where a 4-minute prediction switched the SSR
             * off around 10...12 degC too early.
             */
            else if (error <= MT_PREDICT_ACTIVE_BAND_C &&
                     rising_rate >= MT_MIN_RISING_RATE_C_PER_MIN &&
                     mt_predicted_temp_c >=
                         (target_temp + MT_PREDICT_MARGIN_C)) {
                Enter_MT_Phase(MT_PHASE_COAST, target_temp);
            }
            /* Once inside the -1 degC tolerance band, hand over to HOLD even
             * if the furnace is still moving slowly. HOLD has its own derivative
             * braking and can immediately supply the heat-loss bias.
             */
            else if (error <= MT_HOLD_ENTRY_ERROR_C &&
                     error >= -MT_HARD_CUTOFF_C) {
                Enter_MT_Phase(MT_PHASE_HOLD, target_temp);
            }
            break;

        case MT_PHASE_COAST:
            /* A large, non-rising deficit needs APPROACH directly. This test
             * must precede the ordinary HOLD release condition.
             */
            if (error > MT_REHEAT_ERROR_C &&
                temp_rate_c_per_min <= MT_COAST_RELEASE_RATE_C_PER_MIN) {
                Enter_MT_Phase(MT_PHASE_APPROACH, target_temp);
            }
            /* Do not alternate COAST -> HOLD -> COAST while residual heat still
             * predicts an overshoot. Release once the predicted temperature is
             * safe, or once both error and measured rate are inside the normal
             * HOLD-entry region.
             */
            else if ((error >= MT_TARGET_TOLERANCE_C &&
                      mt_predicted_temp_c <= target_temp) ||
                     (mt_predicted_temp_c <= target_temp &&
                      ((error >= MT_COAST_RELEASE_ERROR_C &&
                        temp_rate_c_per_min <=
                            MT_COAST_RELEASE_RATE_C_PER_MIN) ||
                       (fabsf(error) <= MT_HOLD_ENTRY_ERROR_C &&
                        fabsf(temp_rate_c_per_min) <=
                            MT_HOLD_ENTRY_RATE_C_PER_MIN)))) {
                Enter_MT_Phase(MT_PHASE_HOLD, target_temp);
            }
            break;

        case MT_PHASE_HOLD:
        default:
            if (input_temp >= (target_temp + MT_HARD_CUTOFF_C) ||
                raw_temp >= (target_temp + MT_HARD_CUTOFF_C) ||
                (temp_rate_c_per_min > MT_HOLD_ENTRY_RATE_C_PER_MIN &&
                 mt_predicted_temp_c >=
                     (target_temp + MT_PREDICT_MARGIN_C))) {
                Enter_MT_Phase(MT_PHASE_COAST, target_temp);
            } else if (error > MT_REHEAT_ERROR_C) {
                /* A large disturbance still uses APPROACH, but ordinary
                 * 0...1 degC hold errors do NOT clear the integral anymore.
                 */
                Enter_MT_Phase(MT_PHASE_APPROACH, target_temp);
            }
            break;
    }
}

static float Limit_MT_Output(float requested_output,
                             float target_temp,
                             float input_temp) {
    float limited_output = requested_output;
    const float error = target_temp - input_temp;

    if (mt_control_phase == MT_PHASE_COAST ||
        input_temp >= (target_temp + MT_HARD_CUTOFF_C) ||
        raw_temp >= (target_temp + MT_HARD_CUTOFF_C)) {
        Output = 0.0f;
        pid_heater.outputSum = 0.0f;
        mt_output_limit_ms = 0.0f;
        return 0.0f;
    }

    if (mt_control_phase == MT_PHASE_APPROACH) {
        if (error <= 0.0f) {
            Output = 0.0f;
            pid_heater.outputSum = 0.0f;
            mt_output_limit_ms = 0.0f;
            return 0.0f;
        }

        if (error > 40.0f) {
            mt_output_limit_ms = MT_MAX_OUTPUT_FAR_MS;
        } else if (error > 20.0f) {
            mt_output_limit_ms = MT_MAX_OUTPUT_40_20_MS;
        } else if (error > 10.0f) {
            mt_output_limit_ms = MT_MAX_OUTPUT_20_10_MS;
        } else if (error > 5.0f) {
            mt_output_limit_ms = MT_MAX_OUTPUT_10_5_MS;
        } else if (error > 3.0f) {
            mt_output_limit_ms = MT_MAX_OUTPUT_5_3_MS;
        } else if (error > 2.0f) {
            mt_output_limit_ms = MT_MAX_OUTPUT_3_2_MS;
        } else if (error > 1.0f) {
            mt_output_limit_ms = MT_MAX_OUTPUT_2_1_MS;
        } else {
            mt_output_limit_ms = MT_MAX_OUTPUT_NEAR_MS;
        }

        /* Remember the real near-target actuator demand so HOLD can start
         * bumplessly instead of starting from almost zero output.
         */
        if (limited_output > mt_output_limit_ms) {
            limited_output = mt_output_limit_ms;
        }
        if (limited_output > 0.0f) {
            mt_precoast_output_ms = limited_output;
        }
    } else { /* MT_PHASE_HOLD */
        const float hold_cap = MT_Hold_Output_Cap(target_temp);
        mt_output_limit_ms = hold_cap;

        /* A heater cannot actively cool. Stop heating immediately at/above target.
         * Stored heat will be handled by COAST if the measured/predicted
         * temperature exceeds the small positive margin.
         */
        if (error <= 0.0f) {
            limited_output = 0.0f;
        } else {
            /* Anti-droop floor:
             * When temperature approaches Setpoint-1 degC, guarantee enough
             * heating authority to arrest the decline. This floor is applied
             * after PID so a derivative kick/noise cannot starve the heater.
             */
            float hold_floor_ms = 0.0f;

            if (error >= MT_HOLD_RECOVERY_ERROR_C) {
                hold_floor_ms = hold_cap * MT_HOLD_RECOVERY_FRACTION;
            } else if (error >= MT_HOLD_FLOOR_START_ERROR_C &&
                       temp_rate_c_per_min <=
                           MT_COAST_RELEASE_RATE_C_PER_MIN) {
                hold_floor_ms = hold_cap * MT_HOLD_FLOOR_FRACTION;
            }

            if (limited_output < hold_floor_ms) {
                limited_output = hold_floor_ms;
            }

            /* Guarantee at least one useful SSR pulse while below target and
             * cooling; otherwise the 20 ms deadband can erase a small command.
             */
            if (error > 0.20f && temp_rate_c_per_min < 0.0f &&
                limited_output > 0.0f &&
                limited_output < MT_HOLD_MIN_PULSE_MS) {
                limited_output = MT_HOLD_MIN_PULSE_MS;
            }
        }
    }

    if (limited_output > mt_output_limit_ms) {
        limited_output = mt_output_limit_ms;
    }
    if (limited_output < 0.0f) limited_output = 0.0f;

    /* Back-calculation by clamping the stored integral to the real actuator limit. */
    if (pid_heater.outputSum > mt_output_limit_ms) {
        pid_heater.outputSum = mt_output_limit_ms;
    }
    if (pid_heater.outputSum < 0.0f) pid_heater.outputSum = 0.0f;

    /* Keep the PID-visible Output aligned with the actual limited command.
     * This reduces bumps when moving between APPROACH / HOLD.
     */
    Output = limited_output;

    return limited_output;
}

static void Read_Temperature_Task(uint32_t now_ms) {
    if ((uint32_t)(now_ms - last_temp_read_time) < SENSOR_SAMPLE_MS) return;
    last_temp_read_time = now_ms;

    if (!max31856_ready) {
        Trip_Control_Fault(CONTROL_FAULT_SENSOR_DATA);
        return;
    }

    /* Start each sensor sample with a fresh communication-health latch.
     * Any SPI timeout/error in this sample forces heater OFF immediately.
     */
    MAX31856_ClearCommunicationError(&max31856);

    max31856_fault_bits = MAX31856_ReadFault(&max31856);
    if (MAX31856_HasCommunicationError(&max31856)) {
        invalid_temp_count = 0U;
        valid_recovery_count = 0U;
        Trip_Control_Fault(CONTROL_FAULT_MAX31856);
        return;
    }

    if (max31856_fault_bits != 0U) {
        invalid_temp_count = 0U;
        valid_recovery_count = 0U;
        Trip_Control_Fault(CONTROL_FAULT_MAX31856);
        return;
    }

    const float measured = MAX31856_ReadThermocoupleTemperature(&max31856);
    if (MAX31856_HasCommunicationError(&max31856)) {
        invalid_temp_count = 0U;
        valid_recovery_count = 0U;
        Trip_Control_Fault(CONTROL_FAULT_MAX31856);
        return;
    }

    const bool valid = isfinite(measured) &&
                       measured >= SENSOR_MIN_VALID_C &&
                       measured <= SENSOR_MAX_VALID_C;

    if (!valid) {
        valid_recovery_count = 0U;
        if (invalid_temp_count < 255U) invalid_temp_count++;
        if (invalid_temp_count >= SENSOR_INVALID_LIMIT) {
            Trip_Control_Fault(CONTROL_FAULT_SENSOR_DATA);
        }
        return;
    }

    invalid_temp_count = 0U;
    raw_temp = measured;
    if (!sensor_has_valid_sample || !isfinite(filtered_temp)) {
        filtered_temp = measured;
    } else {
        filtered_temp += TEMP_FILTER_ALPHA * (measured - filtered_temp);
    }

    Current_Temp = filtered_temp;
    Input = filtered_temp;
    sensor_has_valid_sample = true;
    Update_TIOT_Fast_Rate(now_ms);
    Update_Temperature_Rate(now_ms);

    if (measured >= OVERTEMP_TRIP_C || filtered_temp >= OVERTEMP_TRIP_C) {
        valid_recovery_count = 0U;
        Trip_Control_Fault(CONTROL_FAULT_OVERTEMP);
    } else if (Control_Fault == CONTROL_FAULT_OVERTEMP) {
        if (filtered_temp <= OVERTEMP_RESET_C) {
            if (valid_recovery_count < 255U) valid_recovery_count++;
            if (valid_recovery_count >= SENSOR_RECOVERY_VALID_SAMPLES) {
                Control_Fault = CONTROL_FAULT_NONE;
                valid_recovery_count = 0U;
            }
        } else {
            valid_recovery_count = 0U;
        }
    } else if (Control_Fault == CONTROL_FAULT_MAX31856 ||
               Control_Fault == CONTROL_FAULT_SENSOR_DATA) {
        if (valid_recovery_count < 255U) valid_recovery_count++;
        if (valid_recovery_count >= SENSOR_RECOVERY_VALID_SAMPLES) {
            Control_Fault = CONTROL_FAULT_NONE;
            valid_recovery_count = 0U;
        }
    } else {
        valid_recovery_count = 0U;
    }

    if (Current_UI_State == UI_STATE_MAIN) LCD_Needs_Update = true;
}

static void Update_PID_And_SSR(uint32_t now_ms, uint32_t current_run_seconds) {
    if (System_Run_State == SYS_PAUSED) {
        /* Pause is intentionally different from stop: keep the interval and
         * controller memory, but guarantee that no SSR pulse can be emitted.
         */
        HAL_GPIO_WritePin(GPIOB, GPIO_PIN_7, GPIO_PIN_RESET);
        Output = 0.0f;
        active_output = 0.0f;
        return;
    }

    if (System_Run_State != SYS_RUNNING ||
        Control_Fault != CONTROL_FAULT_NONE ||
        !sensor_has_valid_sample) {
        Stop_Heating_Control();
        return;
    }

    const uint8_t interval_index = Current_Interval - 1U;
    const uint8_t interval_mode = Intervals[interval_index].Mode;
    const bool is_mt_mode = (interval_mode == MODE_MT);

    /* Reset the supervisory state only when entering a new segment/mode.
     * TIOT changes Setpoint every second, so Setpoint changes alone must not reset it.
     */
    if (last_control_interval != Current_Interval ||
        last_control_mode != interval_mode) {
        /* Preserve the real duty delivered by the preceding segment before
         * clearing PID state. MT uses it for a bumpless thermal handover; TIOT
         * retains its existing initialization path below.
         */
        const float previous_active_output = active_output;

        mt_control_phase = MT_PHASE_APPROACH;
        mt_predicted_temp_c = Input;
        mt_output_limit_ms = 0.0f;
        mt_precoast_output_ms = 0.0f;
        pid_heater.outputSum = 0.0f;
        Output = 0.0f;
        active_output = 0.0f;
        last_control_interval = Current_Interval;
        last_control_mode = interval_mode;

        tiot_ideal_temp_c = Input;
        tiot_command_setpoint_c = Input;
        tiot_planned_rate_c_per_min = 0.0f;
        tiot_required_rate_c_per_min = 0.0f;
        tiot_output_floor_ms = 0.0f;
        tiot_predicted_temp_c = Input;
        Reset_TIOT_Fast_Rate(now_ms);

        if (is_mt_mode) {
            const float mt_target = (float)Intervals[interval_index].Temp;
            const float mt_entry_error = mt_target - Input;

            /* The final TIOT duty already contains real information about this
             * furnace/load. Retain it when MT starts at or below its target.
             */
            if (mt_entry_error >= 0.0f && previous_active_output > 0.0f) {
                mt_precoast_output_ms = previous_active_output;
                if (mt_precoast_output_ms > (float)WINDOW_SIZE) {
                    mt_precoast_output_ms = (float)WINDOW_SIZE;
                }
            }

            /* A TIOT -> MT handover commonly occurs only 1...3 degC below the
             * target. Start in HOLD with the retained bias instead of starving
             * the heater through a fresh zero-output APPROACH state.
             */
            if (mt_entry_error <= MT_REHEAT_ERROR_C &&
                mt_entry_error >= -MT_HARD_CUTOFF_C) {
                Enter_MT_Phase(MT_PHASE_HOLD, mt_target);
            } else if (mt_entry_error < -MT_HARD_CUTOFF_C) {
                mt_control_phase = MT_PHASE_COAST;
            }
        } else {
            /* Enter TIOT with a deadline-aware controller. Integral is enabled
             * only after the trajectory error is bounded. */
            Apply_PID_Tunings(TIOT_KP, 0.0f, TIOT_KD);
        }
    }

    const float profile_setpoint =
        Calculate_Profile_Setpoint(current_run_seconds);
    Setpoint = is_mt_mode
        ? profile_setpoint
        : Calculate_TIOT_Control_Setpoint(current_run_seconds,
                                          profile_setpoint);

    if (PID_GetMode(&pid_heater) != PID_AUTOMATIC) {
        PID_SetMode(&pid_heater, PID_AUTOMATIC);
    }

    const float error = Setpoint - Input;
    const float abs_error = fabsf(error);

    /* A decreasing trajectory cannot be followed actively by a heater. */
    if (Setpoint < (last_setpoint - 0.25f)) {
        pid_heater.outputSum = 0.0f;
    }

    if (is_mt_mode) {
        Update_MT_Control_Phase(Setpoint, Input);

        if (mt_control_phase == MT_PHASE_HOLD) {
            Apply_PID_Tunings(MT_HOLD_KP, MT_HOLD_KI, MT_HOLD_KD);
        } else {
            /* Approach and coast never integrate stored heat demand. */
            Apply_PID_Tunings(MT_APPROACH_KP, 0.0f, MT_APPROACH_KD);
            pid_heater.outputSum = 0.0f;
        }
    } else {
        mt_control_phase = MT_PHASE_APPROACH;
        mt_predicted_temp_c = tiot_predicted_temp_c;
        mt_output_limit_ms = (float)WINDOW_SIZE;

        /* TIOT needs integral earlier than the original +/-4 degC zone, because
         * zero integral during most of the ramp is the main reason the plant
         * follows the programmed trajectory with a large steady lag.
         */
        if (abs_error <= TIOT_INTEGRAL_ENABLE_BAND_C) {
            Apply_PID_Tunings(TIOT_KP, TIOT_KI, TIOT_KD);
        } else {
            Apply_PID_Tunings(TIOT_KP, 0.0f, TIOT_KD);
            pid_heater.outputSum = 0.0f;
        }

        if (error < -TIOT_HARD_CUTOFF_C) {
            pid_heater.outputSum = 0.0f;
        }
    }

    if (PID_Compute(&pid_heater)) {
        active_output = Output;
    }

    if (is_mt_mode) {
        active_output = Limit_MT_Output(active_output, Setpoint, Input);
    } else {
        active_output =
            Limit_TIOT_Output(active_output, current_run_seconds);
    }

    if (active_output < 0.0f) active_output = 0.0f;
    if (active_output > (float)WINDOW_SIZE) active_output = (float)WINDOW_SIZE;
    last_setpoint = Setpoint;

    /* Time-proportional SSR drive: active_output is ON-time in a 1000 ms window. */
    const uint32_t ms_in_window =
        (uint32_t)(now_ms - windowStartTime) % WINDOW_SIZE;

    if (active_output <= OUTPUT_DEADBAND_MS) {
        HAL_GPIO_WritePin(GPIOB, GPIO_PIN_7, GPIO_PIN_RESET);
    } else if (active_output >= ((float)WINDOW_SIZE - OUTPUT_DEADBAND_MS)) {
        HAL_GPIO_WritePin(GPIOB, GPIO_PIN_7, GPIO_PIN_SET);
    } else {
        HAL_GPIO_WritePin(GPIOB, GPIO_PIN_7,
                          (ms_in_window < (uint32_t)active_output)
                              ? GPIO_PIN_SET
                              : GPIO_PIN_RESET);
    }
}

/**
  * @brief  Main Event Loop for Button Processing
  * @note   Decoupled from ISR to keep interrupts brief. Handles all state machine transitions.
  */
void Process_Buttons(void) {
    uint8_t setting_event;
    uint8_t setting_long_event;
    uint8_t redirect_event;
    uint8_t redirect_long_event;
    uint8_t select_event;
    uint8_t select_long_event;
    uint8_t up_event;
    uint8_t down_event;

    const uint32_t now_ms = HAL_GetTick();
    Update_Hold_Button_Events(now_ms);
    Update_Transient_UI(now_ms);

    /* Atomically snapshot and clear ISR-owned event flags. */
    uint32_t primask = __get_PRIMASK();
    __disable_irq();
    setting_event = button_setting;   button_setting = 0U;
    setting_long_event = button_setting_long; button_setting_long = 0U;
    redirect_event = button_redirect; button_redirect = 0U;
    redirect_long_event = button_redirect_long; button_redirect_long = 0U;
    select_event = button_select;     button_select = 0U;
    select_long_event = button_select_long; button_select_long = 0U;
    up_event = button_tang;           button_tang = 0U;
    down_event = button_giam;         button_giam = 0U;
    if (primask == 0U) __enable_irq();

    /* Confirmation is deliberately modal for its short display interval. */
    if (Current_UI_State == UI_STATE_OPERATION_CONFIRM) return;

    // ---------------------------------------------------------
    // 0. LONG SETTING (PA8) -> SAVED PROGRAM MANAGER
    // ---------------------------------------------------------
    if (setting_long_event) {
        if (Current_UI_State == UI_STATE_MAIN) {
            Enter_Program_Manager();
        } else if (Is_Setting_UI_State(Current_UI_State)) {
            Commit_Pending_Edit();
            Sanitize_Settings();
            Enter_Program_Manager();
        }
        return;
    }

    // ---------------------------------------------------------
    // 0b. LONG REDIRECT (PA9) -> SAFE EXIT FROM SETTING TO IDLE
    // ---------------------------------------------------------
    if (redirect_long_event) {
        if (Is_Setting_UI_State(Current_UI_State) ||
            Current_UI_State == UI_STATE_PROGRAM_MANAGER ||
            (Current_UI_State == UI_STATE_MAIN &&
             (System_Run_State == SYS_RUNNING ||
              System_Run_State == SYS_PAUSED))) {
            Exit_To_Main_Idle();
        }
        return;
    }

    // ---------------------------------------------------------
    // 0c. LONG SELECT (PB15) -> DELETE IN MANAGER / SAVE IN SETTING
    // ---------------------------------------------------------
    if (select_long_event) {
        if (Current_UI_State == UI_STATE_PROGRAM_MANAGER) {
            const uint8_t deleted_slot =
                Program_Manager_Slot_At(Program_Manager_Selection);

            if (deleted_slot < MAX_PROGRAMS) {
                const bool deleted = Delete_Stored_Program(deleted_slot);
                if (deleted) {
                    const uint8_t remaining = Program_Manager_Saved_Count();
                    if (remaining == 0U) {
                        Program_Manager_Selection = 0U;
                        Program_Manager_Top = 0U;
                    } else {
                        if (Program_Manager_Selection >= remaining) {
                            Program_Manager_Selection = remaining - 1U;
                        }
                        Program_Manager_Keep_Selection_Visible();
                    }
                }
                Begin_Operation_Confirmation(CONFIRM_ACTION_DELETE, deleted,
                                             deleted_slot,
                                             UI_STATE_PROGRAM_MANAGER);
            }
            return;
        }

        const bool is_setting_screen =
            Is_Setting_UI_State(Current_UI_State);

        if (is_setting_screen) {
            const UIState_t previous_ui = Current_UI_State;
            Commit_Pending_Edit();
            Sanitize_Settings();

            uint8_t save_slot = Working_Program_Slot;
            if (save_slot >= MAX_PROGRAMS) {
                for (uint8_t i = 0U; i < MAX_PROGRAMS; i++) {
                    if (Stored_Programs[i].ValidMarker != PROGRAM_VALID_MARKER) {
                        save_slot = i;
                        break;
                    }
                }
            }

            const bool saved = Save_Working_Program(save_slot);
            UIState_t return_ui = previous_ui;
            if (saved && Editing_From_Program_Manager) {
                const uint8_t count = Program_Manager_Saved_Count();
                for (uint8_t i = 0U; i < count; i++) {
                    if (Program_Manager_Slot_At(i) == save_slot) {
                        Program_Manager_Selection = i;
                        break;
                    }
                }
                Program_Manager_Keep_Selection_Visible();
                Editing_From_Program_Manager = false;
                return_ui = UI_STATE_PROGRAM_MANAGER;
            }
            Begin_Operation_Confirmation(CONFIRM_ACTION_SAVE, saved,
                                         save_slot, return_ui);
        }
        return;
    }

    // ---------------------------------------------------------
    // 1. SETTING / RUN BUTTON (PA8)
    // ---------------------------------------------------------
    if (setting_event) {
        if (Current_UI_State == UI_STATE_MAIN) {
            Current_UI_State = UI_STATE_SET_INTERVAL;
            System_Run_State = SYS_IDLE;
            Stop_Heating_Control();
            Editing_From_Program_Manager = false;
            Working_Program_Slot = NO_PROGRAM_SLOT;
        } else if (Current_UI_State == UI_STATE_PROGRAM_MANAGER) {
            const uint8_t slot =
                Program_Manager_Slot_At(Program_Manager_Selection);
            if (Load_Program_Slot(slot)) {
                Editing_From_Program_Manager = false;
                Current_UI_State = UI_STATE_MAIN;
                (void)Start_Profile();
            }
        } else {
            /* PA8 means Save & Exit even when currently inside an edit screen. */
            Commit_Pending_Edit();
            Sanitize_Settings();
            Save_Settings_To_Flash();
            Current_UI_State = UI_STATE_MAIN;
            (void)Start_Profile();
        }
        LCD_Needs_Update = true;
        return; /* Do not apply simultaneous events to the newly-entered UI state. */
    }

    // ---------------------------------------------------------
    // 2. REDIRECT BUTTON (PA9)
    // ---------------------------------------------------------
    if (redirect_event) {
        if (Current_UI_State == UI_STATE_PROGRAM_MANAGER) {
            Exit_To_Main_Idle();
            return;
        } else if (Current_UI_State == UI_STATE_MAIN &&
            (System_Run_State == SYS_RUNNING ||
             System_Run_State == SYS_PAUSED)) {
            Exit_To_Main_Idle();
            return; /* Ignore simultaneous events after the process is stopped. */
        } else if (Current_UI_State == UI_STATE_SET_P) {
            Setting_P_Index++;
            if (Setting_P_Index > Total_Intervals) Setting_P_Index = 1U;
        } else if (Current_UI_State == UI_STATE_SET_TEMP) {
            Temp_Digit_Index = (Temp_Digit_Index + 1U) % 4U;
        } else if (Current_UI_State == UI_STATE_SET_TIME) {
            Time_Field_Index = (Time_Field_Index + 1U) % 3U;
        }
        LCD_Needs_Update = true;
    }

    // ---------------------------------------------------------
    // 3. SELECT / OK BUTTON (PB15)
    // ---------------------------------------------------------
    if (select_event) {
        if (Current_UI_State == UI_STATE_MAIN) {
            if (System_Run_State == SYS_RUNNING) {
                Pause_Profile();
            } else if (System_Run_State == SYS_PAUSED) {
                (void)Resume_Profile();
            }
            LCD_Needs_Update = true;
            return;
        } else if (Current_UI_State == UI_STATE_PROGRAM_MANAGER) {
            const uint8_t slot =
                Program_Manager_Slot_At(Program_Manager_Selection);
            if (Load_Program_Slot(slot)) {
                Editing_From_Program_Manager = true;
                Current_UI_State = UI_STATE_SET_INTERVAL;
                Setting_P_Index = 1U;
                Menu_Cursor = 0U;
            }
            LCD_Needs_Update = true;
            return;
        }

        switch (Current_UI_State) {
            case UI_STATE_SET_INTERVAL:
                Sanitize_Settings();
                Current_UI_State = UI_STATE_SET_P;
                Setting_P_Index = 1U;
                Menu_Cursor = 0U;
                break;

            case UI_STATE_SET_P:
                if (Menu_Cursor == 0U) {
                    Intervals[Setting_P_Index - 1U].Mode =
                        (Intervals[Setting_P_Index - 1U].Mode == MODE_MT) ? MODE_TIOT : MODE_MT;
                } else if (Menu_Cursor == 1U) {
                    Temp_Edit_Val = Intervals[Setting_P_Index - 1U].Temp;
                    Temp_Digit_Index = 0U;
                    Current_UI_State = UI_STATE_SET_TEMP;
                } else {
                    Time_Edit_H = Intervals[Setting_P_Index - 1U].Time_Hour;
                    Time_Edit_M = Intervals[Setting_P_Index - 1U].Time_Min;
                    Time_Edit_S = Intervals[Setting_P_Index - 1U].Time_Sec;
                    Time_Field_Index = 0U;
                    Current_UI_State = UI_STATE_SET_TIME;
                }
                break;

            case UI_STATE_SET_TEMP:
            case UI_STATE_SET_TIME:
                Commit_Pending_Edit();
                Current_UI_State = UI_STATE_SET_P;
                break;

            default:
                break;
        }
        LCD_Needs_Update = true;
    }

    // ---------------------------------------------------------
    // 4. UP (PA11) & DOWN (PA10)
    // If both arrive together, ignore the contradictory command.
    // ---------------------------------------------------------
    if ((up_event != 0U) != (down_event != 0U)) {
        const bool is_up = (up_event != 0U);

        switch (Current_UI_State) {
            case UI_STATE_PROGRAM_MANAGER: {
                const uint8_t count = Program_Manager_Saved_Count();
                if (count > 0U) {
                    if (is_up) {
                        Program_Manager_Selection =
                            (Program_Manager_Selection == 0U)
                                ? (count - 1U)
                                : (Program_Manager_Selection - 1U);
                    } else {
                        Program_Manager_Selection++;
                        if (Program_Manager_Selection >= count) {
                            Program_Manager_Selection = 0U;
                        }
                    }
                    Program_Manager_Keep_Selection_Visible();
                }
                break;
            }

            case UI_STATE_SET_INTERVAL:
                if (is_up && Total_Intervals < MAX_INTERVALS) Total_Intervals++;
                else if (!is_up && Total_Intervals > 1U) Total_Intervals--;
                break;

            case UI_STATE_SET_P:
                if (is_up) Menu_Cursor = (Menu_Cursor > 0U) ? (Menu_Cursor - 1U) : 2U;
                else Menu_Cursor = (Menu_Cursor < 2U) ? (Menu_Cursor + 1U) : 0U;
                break;

            case UI_STATE_SET_TEMP: {
                uint8_t d[4];
                d[0] = (uint8_t)(Temp_Edit_Val / 1000U);
                d[1] = (uint8_t)((Temp_Edit_Val / 100U) % 10U);
                d[2] = (uint8_t)((Temp_Edit_Val / 10U) % 10U);
                d[3] = (uint8_t)(Temp_Edit_Val % 10U);

                if (is_up) d[Temp_Digit_Index] = (d[Temp_Digit_Index] == 9U) ? 0U : (d[Temp_Digit_Index] + 1U);
                else d[Temp_Digit_Index] = (d[Temp_Digit_Index] == 0U) ? 9U : (d[Temp_Digit_Index] - 1U);

                Temp_Edit_Val = (uint16_t)(d[0] * 1000U + d[1] * 100U + d[2] * 10U + d[3]);
                if (Temp_Edit_Val > PROCESS_MAX_TEMP_C) Temp_Edit_Val = PROCESS_MAX_TEMP_C;
                break;
            }

            case UI_STATE_SET_TIME:
                if (Time_Field_Index == 0U) {
                    if (is_up) Time_Edit_H = (Time_Edit_H == 99U) ? 0U : (Time_Edit_H + 1U);
                    else Time_Edit_H = (Time_Edit_H == 0U) ? 99U : (Time_Edit_H - 1U);
                } else if (Time_Field_Index == 1U) {
                    if (is_up) Time_Edit_M = (Time_Edit_M == 59U) ? 0U : (Time_Edit_M + 1U);
                    else Time_Edit_M = (Time_Edit_M == 0U) ? 59U : (Time_Edit_M - 1U);
                } else {
                    if (is_up) Time_Edit_S = (Time_Edit_S == 59U) ? 0U : (Time_Edit_S + 1U);
                    else Time_Edit_S = (Time_Edit_S == 0U) ? 59U : (Time_Edit_S - 1U);
                }
                break;

            default:
                break;
        }
        LCD_Needs_Update = true;
    }
}

/**
  * @brief  Advanced Display Renderer
  * @note   Implements String Double-Buffering. We assemble the entire row string in RAM,
  * compare it to what is currently on the screen, and only execute I2C writes
  * if the string actually changed. This completely eliminates UI flickering.
  */
void Update_LCD(void) {
    if (!LCD_Needs_Update) return;
    LCD_Needs_Update = false;

    char row1[17];
    char row2[17];
    char temp_buf[32];

    memset(row1, ' ', 16U); row1[16] = '\0';
    memset(row2, ' ', 16U); row2[16] = '\0';

    switch (Current_UI_State) {
        case UI_STATE_MAIN: {
            if (Control_Fault != CONTROL_FAULT_NONE) {
                if (Control_Fault == CONTROL_FAULT_OVERTEMP) {
                    snprintf(temp_buf, sizeof(temp_buf), "==OVER TEMP!==");
                } else {
                    snprintf(temp_buf, sizeof(temp_buf), "==SENSOR ERROR==");
                }
                Copy_To_LCD_Row(row1, temp_buf);
                Copy_To_LCD_Row(row2, "SSR: OFF");
            } else {
                const int display_temp = sensor_has_valid_sample ? (int)lroundf(Current_Temp) : 0;
                if (System_Run_State == SYS_IDLE) {
                    snprintf(temp_buf, sizeof(temp_buf), "Temp:%4d" "\xDF" "C P0/%u",
                             display_temp, (unsigned int)Total_Intervals);
                } else if (System_Run_State == SYS_PAUSED) {
                    snprintf(temp_buf, sizeof(temp_buf), "T:%4d" "\xDF" "C PAUSE", display_temp);
                } else if (System_Run_State == SYS_COMPLETED) {
                    snprintf(temp_buf, sizeof(temp_buf), "Temp:%4d" "\xDF" "C DONE", display_temp);
                } else {
                    snprintf(temp_buf, sizeof(temp_buf), "Temp:%4d" "\xDF" "C P%u/%u",
                             display_temp, (unsigned int)Current_Interval,
                             (unsigned int)Total_Intervals);
                }
                Copy_To_LCD_Row(row1, temp_buf);

                const uint32_t elapsed = Run_Total_Seconds;
                const uint32_t hours = elapsed / 3600U;
                const uint32_t minutes = (elapsed / 60U) % 60U;
                const uint32_t seconds = elapsed % 60U;
                if (hours <= 99U) {
                    snprintf(temp_buf, sizeof(temp_buf), "Time: %02lu:%02lu:%02lu",
                             (unsigned long)hours, (unsigned long)minutes, (unsigned long)seconds);
                } else {
                    snprintf(temp_buf, sizeof(temp_buf), "Time:%03lu:%02lu:%02lu",
                             (unsigned long)hours, (unsigned long)minutes, (unsigned long)seconds);
                }
                Copy_To_LCD_Row(row2, temp_buf);
            }
            break;
        }

        case UI_STATE_SET_INTERVAL:
            Copy_To_LCD_Row(row1, "[SET INTERVAL]");
            snprintf(temp_buf, sizeof(temp_buf), "Quantity: %u", (unsigned int)Total_Intervals);
            Copy_To_LCD_Row(row2, temp_buf);
            break;

        case UI_STATE_SET_P:
            snprintf(temp_buf, sizeof(temp_buf), "==== SET P%u ====", (unsigned int)Setting_P_Index);
            Copy_To_LCD_Row(row1, temp_buf);
            if (Menu_Cursor == 0U) {
                snprintf(temp_buf, sizeof(temp_buf), ">Mode: %s",
                         (Intervals[Setting_P_Index - 1U].Mode == MODE_MT) ? "MT" : "TIOT");
            } else if (Menu_Cursor == 1U) {
                snprintf(temp_buf, sizeof(temp_buf), ">Set Temp");
            } else {
                snprintf(temp_buf, sizeof(temp_buf), ">Set Time");
            }
            Copy_To_LCD_Row(row2, temp_buf);
            break;

        case UI_STATE_SET_TEMP:
            snprintf(temp_buf, sizeof(temp_buf), "[SET TEMP P%u]", (unsigned int)Setting_P_Index);
            Copy_To_LCD_Row(row1, temp_buf);
            snprintf(temp_buf, sizeof(temp_buf), "Thres: %04u " "\xDF" "C", (unsigned int)Temp_Edit_Val);
            Copy_To_LCD_Row(row2, temp_buf);
            break;

        case UI_STATE_SET_TIME:
            snprintf(temp_buf, sizeof(temp_buf), "[SET TIME P%u]", (unsigned int)Setting_P_Index);
            Copy_To_LCD_Row(row1, temp_buf);
            snprintf(temp_buf, sizeof(temp_buf), "Time: %02u:%02u:%02u",
                     (unsigned int)Time_Edit_H, (unsigned int)Time_Edit_M,
                     (unsigned int)Time_Edit_S);
            Copy_To_LCD_Row(row2, temp_buf);
            break;

        case UI_STATE_PROGRAM_MANAGER: {
            const uint8_t count = Program_Manager_Saved_Count();
            if (count == 0U) {
                Copy_To_LCD_Row(row1, "== NO PROGRAM ==");
                Copy_To_LCD_Row(row2, "PA9: EXIT");
                break;
            }

            Program_Manager_Keep_Selection_Visible();
            const uint8_t first_list_index = Program_Manager_Top;
            const uint8_t first_slot =
                Program_Manager_Slot_At(first_list_index);
            if (first_slot < MAX_PROGRAMS) {
                snprintf(temp_buf, sizeof(temp_buf), "%cC%u/P%lu",
                         (Program_Manager_Selection == first_list_index) ? '>' : ' ',
                         (unsigned int)(first_slot + 1U),
                         (unsigned long)Stored_Programs[first_slot].TotalIntervals);
                Copy_To_LCD_Row(row1, temp_buf);
            }

            const uint8_t second_list_index = first_list_index + 1U;
            if (second_list_index < count) {
                const uint8_t second_slot =
                    Program_Manager_Slot_At(second_list_index);
                if (second_slot < MAX_PROGRAMS) {
                    snprintf(temp_buf, sizeof(temp_buf), "%cC%u/P%lu",
                             (Program_Manager_Selection == second_list_index) ? '>' : ' ',
                             (unsigned int)(second_slot + 1U),
                             (unsigned long)Stored_Programs[second_slot].TotalIntervals);
                    Copy_To_LCD_Row(row2, temp_buf);
                }
            }
            break;
        }

        case UI_STATE_OPERATION_CONFIRM:
            if (Confirmation_Action == CONFIRM_ACTION_DELETE) {
                Copy_To_LCD_Row(row1, Confirmation_Success
                    ? "=== DELETED ===" : "DELETE FAILED");
            } else {
                Copy_To_LCD_Row(row1, Confirmation_Success
                    ? "=== SAVED! ===" : "SAVE FAILED");
            }

            if (Confirmation_Success &&
                Confirmation_Program_Slot < MAX_PROGRAMS) {
                snprintf(temp_buf, sizeof(temp_buf), "PROGRAM C%u",
                         (unsigned int)(Confirmation_Program_Slot + 1U));
                Copy_To_LCD_Row(row2, temp_buf);
            } else if (!Confirmation_Success) {
                Copy_To_LCD_Row(row2, "CHECK FLASH");
            }
            break;

        default:
            break;
    }

    if (strcmp(row1, prev_lcd_row1) != 0) {
        LCDI2C_setCursor(0U, 0U);
        LCDI2C_write_String(row1);
        strcpy(prev_lcd_row1, row1);
    }
    if (strcmp(row2, prev_lcd_row2) != 0) {
        LCDI2C_setCursor(0U, 1U);
        LCDI2C_write_String(row2);
        strcpy(prev_lcd_row2, row2);
    }

    if (Current_UI_State == UI_STATE_SET_TEMP) {
        LCDI2C_setCursor((uint8_t)(7U + Temp_Digit_Index), 1U);
        LCDI2C_blink_on();
    } else if (Current_UI_State == UI_STATE_SET_TIME) {
        const uint8_t col = (Time_Field_Index == 0U) ? 6U :
                            ((Time_Field_Index == 1U) ? 9U : 12U);
        LCDI2C_setCursor(col, 1U);
        LCDI2C_blink_on();
    } else {
        LCDI2C_blink_off();
    }
}

/**
  * @brief  Fallback Initializer
  * @note   Used when Flash memory is empty (new MCU) or corrupted.
  */
void Init_Default_Intervals(void) {
    memset(Intervals, 0, sizeof(Intervals));
    for (uint8_t i = 0U; i < MAX_INTERVALS; i++) {
        Intervals[i].Mode = MODE_MT;
    }
    Total_Intervals = 1U;
}

static uint32_t Flash_Checksum_Bytes(const void *data, size_t count) {
    const uint8_t *bytes = (const uint8_t *)data;
    uint32_t hash = 2166136261UL; /* FNV-1a */

    for (size_t i = 0U; i < count; i++) {
        hash ^= bytes[i];
        hash *= 16777619UL;
    }
    return hash;
}

static uint32_t Flash_Checksum(const Flash_Data_t *data) {
    return Flash_Checksum_Bytes(data, offsetof(Flash_Data_t, Checksum));
}

/**
  * @brief  Write validated parameters to the last Flash page.
  */
void Save_Settings_To_Flash(void) {
    Sanitize_Settings();

    memset(&flash_staging_data, 0, sizeof(flash_staging_data));
    flash_staging_data.MagicWord = FLASH_MAGIC_WORD;
    flash_staging_data.Version = FLASH_DATA_VERSION;
    flash_staging_data.ActiveProgramSlot =
        (Active_Program_Slot < MAX_PROGRAMS)
            ? (uint32_t)Active_Program_Slot
            : (uint32_t)NO_PROGRAM_SLOT;
    flash_staging_data.WorkingTotalIntervals = (uint32_t)Total_Intervals;
    memcpy(flash_staging_data.WorkingIntervals,
           Intervals, sizeof(Intervals));
    memcpy(flash_staging_data.Programs,
           Stored_Programs, sizeof(Stored_Programs));
    flash_staging_data.Checksum = Flash_Checksum(&flash_staging_data);

    const uint32_t *data_ptr = (const uint32_t *)&flash_staging_data;
    const uint16_t num_words = (uint16_t)((sizeof(Flash_Data_t) + 3U) / 4U);
    FLASH_EraseInitTypeDef erase = {0};
    uint32_t page_error = 0U;
    HAL_StatusTypeDef status;

    flash_write_ok = false;
    const uint32_t primask = __get_PRIMASK();
    __disable_irq();

    status = HAL_FLASH_Unlock();
    if (status == HAL_OK) {
        erase.TypeErase = FLASH_TYPEERASE_PAGES;
        erase.Banks = FLASH_BANK_1;
        erase.PageAddress = FLASH_STORAGE_ADDR;
        erase.NbPages = 1U;

        status = HAL_FLASHEx_Erase(&erase, &page_error);
        if (status == HAL_OK) {
            for (uint16_t i = 0U; i < num_words; i++) {
                status = HAL_FLASH_Program(FLASH_TYPEPROGRAM_WORD,
                                           FLASH_STORAGE_ADDR + ((uint32_t)i * 4U),
                                           data_ptr[i]);
                if (status != HAL_OK) break;
            }
        }
        (void)HAL_FLASH_Lock();
    }

    if (primask == 0U) __enable_irq();

    if (status == HAL_OK) {
        const Flash_Data_t *stored = (const Flash_Data_t *)FLASH_STORAGE_ADDR;
        flash_write_ok = (stored->MagicWord == FLASH_MAGIC_WORD) &&
                         (stored->Version == FLASH_DATA_VERSION) &&
                         (stored->Checksum == Flash_Checksum(stored));
    }
}

/**
  * @brief  Load settings only when magic, version, size fields and checksum are valid.
  */
void Load_Settings_From_Flash(void) {
    const Flash_Data_t *flash_data = (const Flash_Data_t *)FLASH_STORAGE_ADDR;
    const bool header_valid = (flash_data->MagicWord == FLASH_MAGIC_WORD) &&
                              (flash_data->Version == FLASH_DATA_VERSION) &&
                              (flash_data->WorkingTotalIntervals >= 1U) &&
                              (flash_data->WorkingTotalIntervals <= MAX_INTERVALS);

    if (header_valid && flash_data->Checksum == Flash_Checksum(flash_data)) {
        Total_Intervals = (uint8_t)flash_data->WorkingTotalIntervals;
        memcpy(Intervals, flash_data->WorkingIntervals, sizeof(Intervals));
        memcpy(Stored_Programs, flash_data->Programs, sizeof(Stored_Programs));

        for (uint8_t i = 0U; i < MAX_PROGRAMS; i++) {
            if (Stored_Programs[i].ValidMarker == PROGRAM_VALID_MARKER) {
                Sanitize_Program(&Stored_Programs[i]);
            } else {
                memset(&Stored_Programs[i], 0, sizeof(Stored_Programs[i]));
            }
        }

        const uint8_t stored_active = (uint8_t)flash_data->ActiveProgramSlot;
        if (stored_active < MAX_PROGRAMS &&
            Stored_Programs[stored_active].ValidMarker == PROGRAM_VALID_MARKER) {
            Active_Program_Slot = stored_active;
        } else {
            Active_Program_Slot = NO_PROGRAM_SLOT;
        }
        Working_Program_Slot = Active_Program_Slot;
        Sanitize_Settings();
        return;
    }

    /* Migrate the former single-profile version into working settings and C1.
     * The upgrade is persisted on the next explicit save, avoiding a Flash
     * erase during boot.
     */
    const Legacy_Flash_Data_t *legacy =
        (const Legacy_Flash_Data_t *)FLASH_STORAGE_ADDR;
    const bool legacy_header_valid =
        (legacy->MagicWord == FLASH_MAGIC_WORD) &&
        (legacy->Version == FLASH_LEGACY_VERSION) &&
        (legacy->TotalIntervals >= 1U) &&
        (legacy->TotalIntervals <= MAX_INTERVALS);
    const uint32_t legacy_checksum = Flash_Checksum_Bytes(
        legacy, offsetof(Legacy_Flash_Data_t, Checksum));

    memset(Stored_Programs, 0, sizeof(Stored_Programs));
    if (legacy_header_valid && legacy->Checksum == legacy_checksum) {
        Total_Intervals = (uint8_t)legacy->TotalIntervals;
        memcpy(Intervals, legacy->Intervals, sizeof(Intervals));
        Sanitize_Settings();

        Stored_Programs[0].ValidMarker = PROGRAM_VALID_MARKER;
        Stored_Programs[0].TotalIntervals = (uint32_t)Total_Intervals;
        memcpy(Stored_Programs[0].Intervals, Intervals, sizeof(Intervals));
        Active_Program_Slot = 0U;
        Working_Program_Slot = 0U;
    } else {
        Init_Default_Intervals();
        Active_Program_Slot = NO_PROGRAM_SLOT;
        Working_Program_Slot = NO_PROGRAM_SLOT;
    }
}

/* USER CODE END 0 */

/**
  * @brief  The application entry point.
  * @retval int
  */
int main(void)
{

  /* MCU Configuration--------------------------------------------------------*/

  /* Reset of all peripherals, Initializes the Flash interface and the Systick. */
  HAL_Init();

  /* Configure the system clock */
  SystemClock_Config();

  /* Initialize all configured peripherals */
  MX_GPIO_Init();
  MX_TIM2_Init();
  MX_I2C2_Init();
  MX_SPI1_Init();
  /* USER CODE BEGIN 2 */
  // Load persistence data into RAM *before* starting any operation logic.
    Load_Settings_From_Flash();

  //====== Init LCD16x2 I2C ======//
    LCDI2C_init(&hi2c2, 0x27, 16, 2);
    LCDI2C_backlight();
    LCDI2C_clear();

  //====== Init timer 2 (1Hz) ======//
    HAL_TIM_Base_Start_IT(&htim2);

  //====== Init MAX31856 ======//
    max31856_ready = MAX31856_Init(&max31856, &hspi1, GPIOB, GPIO_PIN_6);
    if (max31856_ready) {
        /* Configuration writes are also checked. A sensor that responds during
         * MAX31856_Init() but fails during Type-S / 50 Hz / continuous-mode
         * configuration is not accepted as ready.
         */
        MAX31856_ClearCommunicationError(&max31856);
        MAX31856_SetThermocoupleType(&max31856, MAX31856_TCTYPE_S);
        MAX31856_SetNoiseFilter(&max31856, MAX31856_NOISE_FILTER_50HZ);
        MAX31856_SetConversionMode(&max31856, MAX31856_CONTINUOUS);

        if (MAX31856_HasCommunicationError(&max31856)) {
            max31856_ready = false;
            Control_Fault = CONTROL_FAULT_MAX31856;
        } else {
            last_temp_read_time = HAL_GetTick();
            sensor_has_valid_sample = false;
        }
    } else {
        Control_Fault = CONTROL_FAULT_MAX31856;
    }

  //====== Init PID ======//
    Setpoint = 0.0f;
    PID_Init(&pid_heater, &Input, &Output, &Setpoint, Kp, Ki, Kd, PID_P_ON_E, PID_DIRECT);
    PID_SetMode(&pid_heater, PID_MANUAL); // By default, it's off until you press RUN
    PID_SetOutputLimits(&pid_heater, 0.0f, (float)WINDOW_SIZE);
    PID_SetSampleTime(&pid_heater, WINDOW_SIZE);
    windowStartTime = HAL_GetTick();

  //====== Init Independent Watchdog ======//
    /* Start IWDG only after GPIO, sensor interface and PID are initialized.
     * After this point the watchdog cannot be stopped by software.
     */
    MX_IWDG_Init();

  /* USER CODE END 2 */

  /* Infinite loop */
  /* USER CODE BEGIN WHILE */
  while (1)
  {
      const uint32_t now_ms = HAL_GetTick();

      Read_Temperature_Task(now_ms);
      Process_Buttons();

      const uint32_t current_run_seconds = Run_Total_Seconds;
      Advance_Profile_If_Needed(current_run_seconds);
      Update_PID_And_SSR(now_ms, current_run_seconds);
      Update_LCD();

      /* Refresh only after ALL foreground tasks returned successfully.
       * If SPI/control/LCD code blocks indefinitely, this line is not reached
       * and IWDG resets the MCU; startup code then configures PB7 LOW again.
       */
      IWDG->KR = IWDG_KR_REFRESH_KEY;
    /* USER CODE END WHILE */

    /* USER CODE BEGIN 3 */
  }
  /* USER CODE END 3 */
}

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
