NguyenHien-8/Nabertherm/(commit log)

2026-06-30 update project
    [Nabertherm_PCB.pdsprj]
2026-07-08 Update Src
    [Nabertherm_PCB [20260705, 15-55-16].pdsprj, Nabertherm_PCB [20260705, 15-57-13].pdsprj, Nabertherm_PCB [20260705, 15-57-44].pdsprj, Nabertherm_PCB [20260705, 16-00-52].pdsprj, Nabertherm_PCB [20260707, 23-15-27].pdsprj, Nabertherm_PCB [20260707, 23-27-52].pdsprj, Nabertherm_PCB [20260707, 23-27-53].pdsprj, Nabertherm_PCB [20260707, 23-27-54].pdsprj]
