NguyenHien-8/Nabertherm/(notices)

Notices in the files:
Temperature_Control_Algorithm/Core/Src/main.c:
Copyright (c) 2026 STMicroelectronics.
All rights reserved.
This software is licensed under terms that can be found in the LICENSE file
